yuanhaozhe2022-eng/OpenTank_Public/README.md

# OpenTank_Public
OpenTank board and code
