yuanhaozhe2022-eng/OpenTank_Public/gyro_board/gyro_board.kicad_pcb

## KiCad design gyro_board/gyro_board.kicad_pcb (2026-11-02)

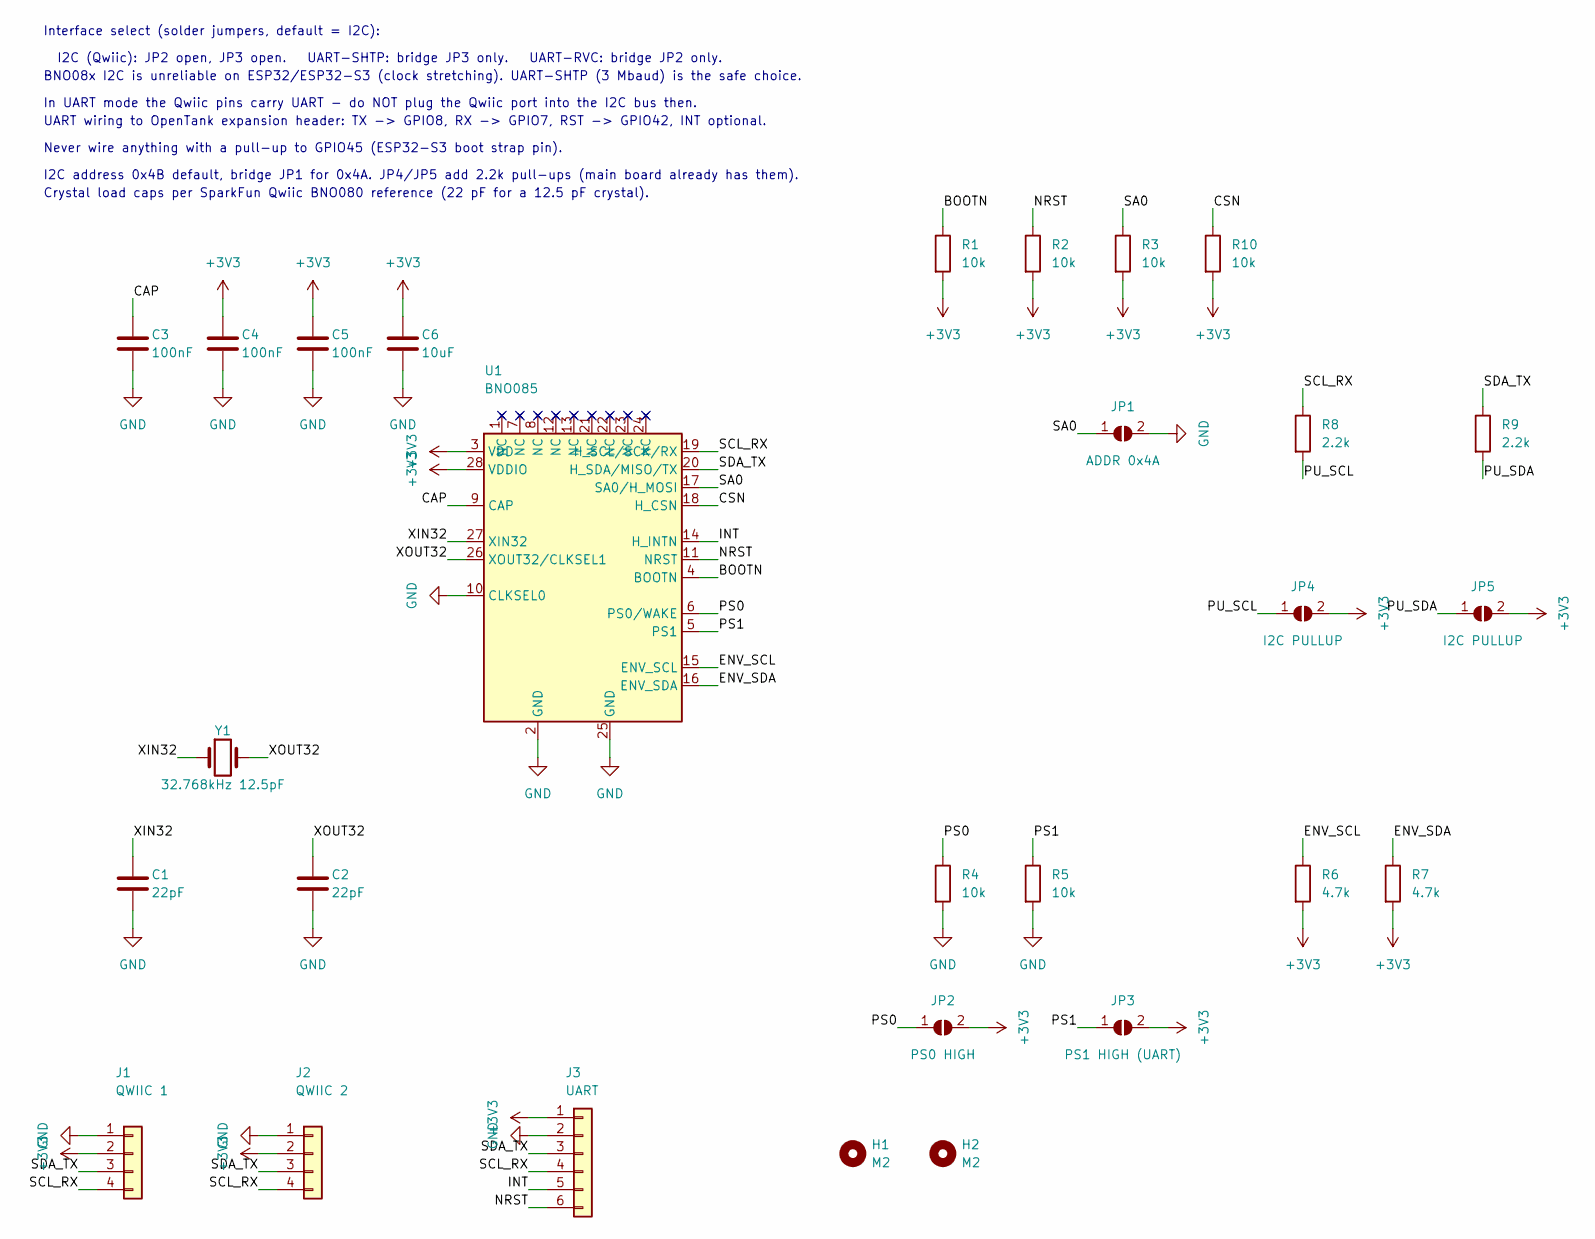
[picture p1: schematic gyro_board.kicad_sch, OpenTank Gyro - BNO085 9-axis IMU]

Parts:
C1, C2: 22pF; C_0603_1608Metric
C3, C4, C5: 100nF; C_0603_1608Metric
C6: 10uF; C_0805_2012Metric
H1, H2: M2; MountingHole_2.2mm_M2
J1: QWIIC 1; JST_SH_SM04B-SRSS-TB_1x04-1MP_P1.00mm_Horizontal; MPN JST SM04B-SRSS-TB
J2: QWIIC 2; JST_SH_SM04B-SRSS-TB_1x04-1MP_P1.00mm_Horizontal; MPN JST SM04B-SRSS-TB
J3: UART; PinHeader_1x06_P2.54mm_Vertical
JP1: ADDR 0x4A; SolderJumper-2_P1.3mm_Open_RoundedPad1.0x1.5mm
JP2: PS0 HIGH; SolderJumper-2_P1.3mm_Open_RoundedPad1.0x1.5mm
JP3: PS1 HIGH (UART); SolderJumper-2_P1.3mm_Open_RoundedPad1.0x1.5mm
JP4, JP5: I2C PULLUP; SolderJumper-2_P1.3mm_Open_RoundedPad1.0x1.5mm
R1, R2, R3, R4, R5, R10: 10k; R_0603_1608Metric
R6, R7: 4.7k; R_0603_1608Metric
R8, R9: 2.2k; R_0603_1608Metric
U1: BNO085; LGA-28_5.2x3.8mm_P0.5mm; MPN BNO085
Y1: 32.768kHz 12.5pF; Crystal_SMD_3215-2Pin_3.2x1.5mm; MPN ABS07-32.768KHZ-T

Connections:
+3V3: C4.1, C5.1, C6.1, J1.2, J2.2, J3.1, JP2.2 (B), JP3.2 (B), JP4.2 (B), JP5.2 (B), R1.2, R2.2, R3.2, R6.2, R7.2, R10.2, U1.3 (VDD), U1.28 (VDDIO)
/BOOTN: R1.1, U1.4 (BOOTN)
/CAP: C3.1, U1.9 (CAP)
/CSN: R10.1, U1.18 (H_CSN)
/ENV_SCL: R6.1, U1.15 (ENV_SCL)
/ENV_SDA: R7.1, U1.16 (ENV_SDA)
/INT: J3.5, U1.14 (H_INTN)
/NRST: J3.6, R2.1, U1.11 (NRST)
/PS0: JP2.1 (A), R4.1, U1.6 (PS0/WAKE)
/PS1: JP3.1 (A), R5.1, U1.5 (PS1)
/PU_SCL: JP4.1 (A), R8.2
/PU_SDA: JP5.1 (A), R9.2
/SA0: JP1.1 (A), R3.1, U1.17 (SA0/H_MOSI)
/SCL_RX: J1.4, J2.4, J3.4, R8.1, U1.19 (H_SCL/SCK/RX)
/SDA_TX: J1.3, J2.3, J3.3, R9.1, U1.20 (H_SDA/MISO/TX)
/XIN32: C1.1, U1.27 (XIN32), Y1.1
/XOUT32: C2.1, U1.26 (XOUT32/CLKSEL1), Y1.2
GND: C1.2, C2.2, C3.2, C4.2, C5.2, C6.2, J1.1, J2.1, J3.2, JP1.2 (B), R4.2, R5.2, U1.2 (GND), U1.10 (CLKSEL0), U1.25 (GND)

Notes on the sheet:
Interface select (solder jumpers, default = I2C):
I2C (Qwiic): JP2 open, JP3 open. UART-SHTP: bridge JP3 only. UART-RVC: bridge JP2 only.
BNO08x I2C is unreliable on ESP32/ESP32-S3 (clock stretching). UART-SHTP (3 Mbaud) is the safe choice.
In UART mode the Qwiic pins carry UART - do NOT plug the Qwiic port into the I2C bus then.
UART wiring to OpenTank expansion header: TX -> GPIO8, RX -> GPIO7, RST -> GPIO42, INT optional.
Never wire anything with a pull-up to GPIO45 (ESP32-S3 boot strap pin).
I2C address 0x4B default, bridge JP1 for 0x4A. JP4/JP5 add 2.2k pull-ups (main board already has them).
Crystal load caps per SparkFun Qwiic BNO080 reference (22 pF for a 12.5 pF crystal).

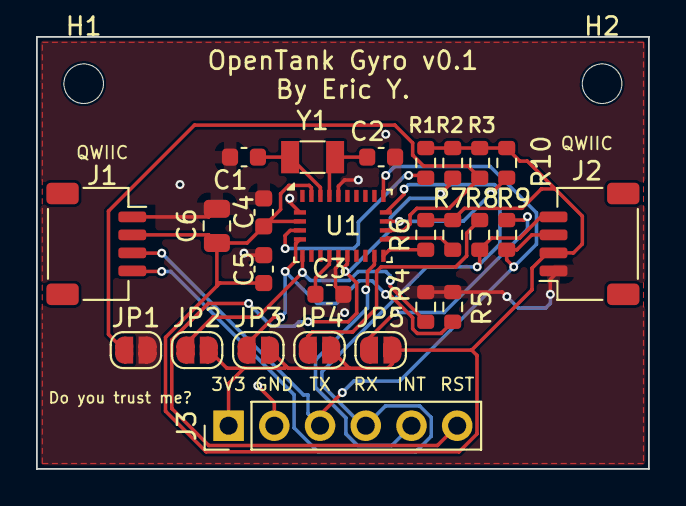
[picture p2: board gyro_board.kicad_pcb from above]

Board: 2 copper layers, 34.0 x 24.0 mm, 28 parts (0 on the bottom side), 18 nets.
