yuanhaozhe2022-eng/OpenTank_Public/tank_board.kicad_pcb

## KiCad design tank_board.kicad_pcb (2026-10-31)

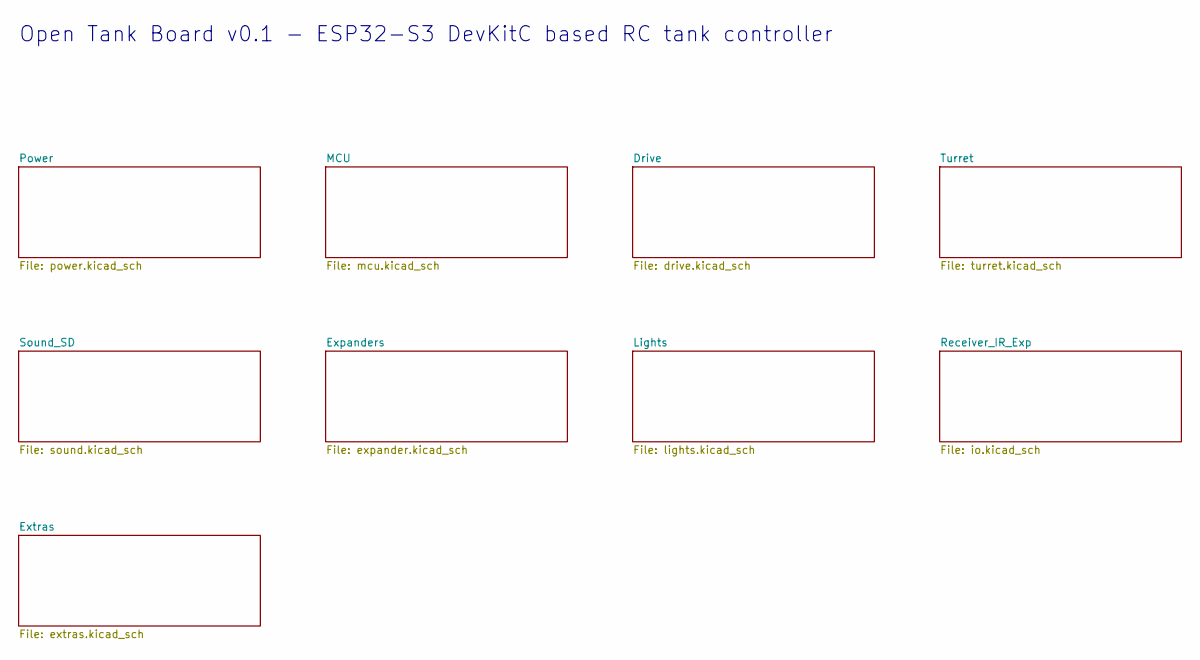
[picture p3: schematic tank_board.kicad_sch, Open Tank Board - ESP32-S3 RC tank controller]

Notes on the sheet:
Open Tank Board v0.1 - ESP32-S3 DevKitC based RC tank controller

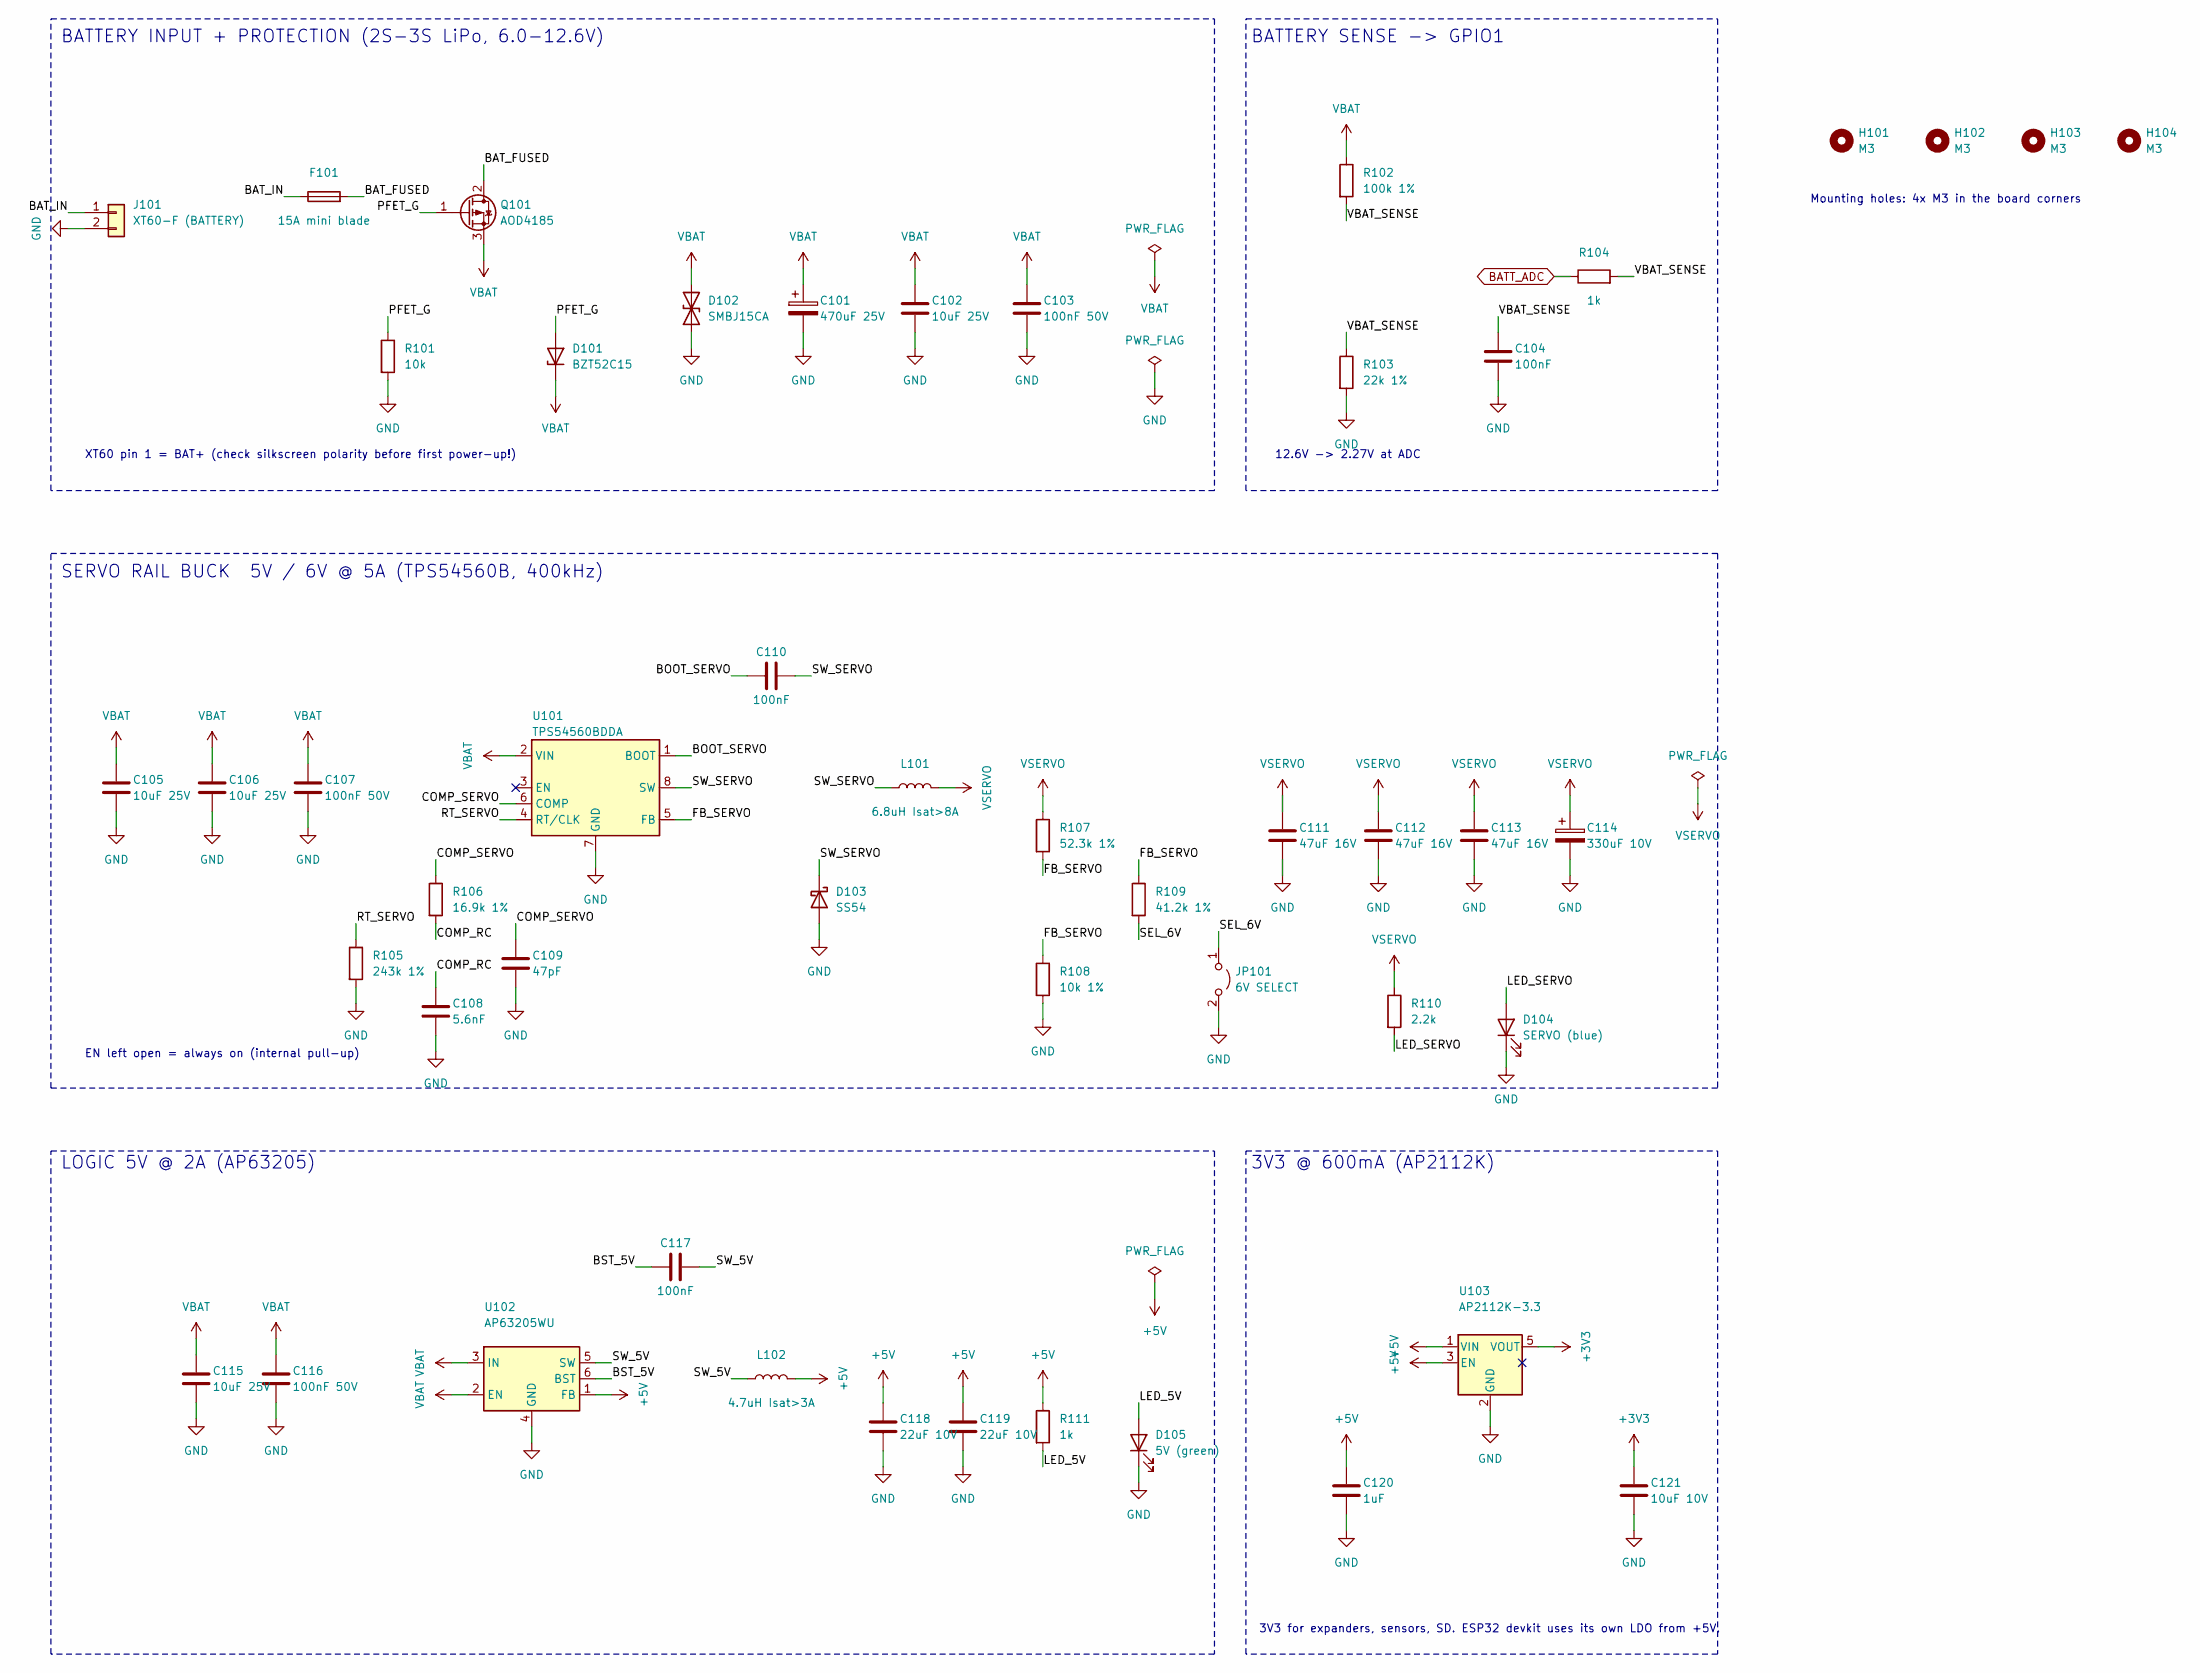
[picture p4: schematic power.kicad_sch, Tank Board - Power]

Parts:
C101: 470uF 25V; CP_Elec_10x10.5
C102, C105, C106, C115: 10uF 25V; C_1206_3216Metric
C103, C107, C116: 100nF 50V; C_0603_1608Metric
C104, C110, C117: 100nF; C_0603_1608Metric
C108: 5.6nF; C_0603_1608Metric
C109: 47pF; C_0603_1608Metric
C111, C112, C113: 47uF 16V; C_1210_3225Metric
C114: 330uF 10V; CP_Elec_6.3x7.7
C118, C119: 22uF 10V; C_1206_3216Metric
C120: 1uF; C_0603_1608Metric
C121: 10uF 10V; C_0805_2012Metric
D101: BZT52C15; D_SOD-123; MPN BZT52C15
D102: SMBJ15CA; D_SMB; MPN SMBJ15CA
D103: SS54; D_SMC; MPN SS54 (40V 5A)
D104: SERVO (blue); LED_0603_1608Metric
D105: 5V (green); LED_0603_1608Metric
F101: 15A mini blade; Fuseholder_Blade_Mini_Keystone_3568; MPN Keystone 3568 + 15A ATM fuse
H101, H102, H103, H104: M3; MountingHole_3.2mm_M3
J101: XT60-F (BATTERY); AMASS_XT60-F_1x02_P7.20mm_Vertical; MPN AMASS XT60-F
JP101: 6V SELECT; PinHeader_1x02_P2.54mm_Vertical
L101: 6.8uH Isat>8A; L_Bourns_SRP1038C_10.0x10.0mm; MPN Bourns SRP1038C-6R8M
L102: 4.7uH Isat>3A; L_Bourns_SRP5030T; MPN Bourns SRP5030T-4R7M
Q101: AOD4185; TO-252-2; MPN AOD4185
R101: 10k; R_0603_1608Metric
R102: 100k 1%; R_0603_1608Metric
R103: 22k 1%; R_0603_1608Metric
R104, R111: 1k; R_0603_1608Metric
R105: 243k 1%; R_0603_1608Metric
R106: 16.9k 1%; R_0603_1608Metric
R107: 52.3k 1%; R_0603_1608Metric
R108: 10k 1%; R_0603_1608Metric
R109: 41.2k 1%; R_0603_1608Metric
R110: 2.2k; R_0603_1608Metric
U101: TPS54560BDDA; Texas_R-PDSO-G8_EP2.95x4.9mm_Mask2.4x3.1mm_ThermalVias; MPN TPS54560BDDAR
U102: AP63205WU; TSOT-23-6; MPN AP63205WU-7
U103: AP2112K-3.3; SOT-23-5; MPN AP2112K-3.3TRG1

Connections:
+3V3: C121.1, U103.5 (VOUT); also elsewhere on the board
+5V: C118.1, C119.1, C120.1, L102.2, R111.1, U102.1 (FB), U103.1 (VIN), U103.3 (EN); also elsewhere on the board
/Power/BAT_FUSED: F101.2, Q101.2 (D)
/Power/BAT_IN: F101.1, J101.1
/Power/BOOT_SERVO: C110.1, U101.1 (BOOT)
/Power/BST_5V: C117.1, U102.6 (BST)
/Power/COMP_RC: C108.1, R106.2
/Power/COMP_SERVO: C109.1, R106.1, U101.6 (COMP)
/Power/FB_SERVO: R107.2, R108.1, R109.1, U101.5 (FB)
/Power/LED_5V: D105.2 (A), R111.2
/Power/LED_SERVO: D104.2 (A), R110.2
/Power/PFET_G: D101.2 (A), Q101.1 (G), R101.1
/Power/RT_SERVO: R105.1, U101.4 (RT/CLK)
/Power/SEL_6V: JP101.1 (A), R109.2
/Power/SW_5V: C117.2, L102.1, U102.5 (SW)
/Power/SW_SERVO: C110.2, D103.1 (K), L101.1, U101.8 (SW)
/Power/VBAT_SENSE: C104.1, R102.2, R103.1, R104.2
BATT_ADC: R104.1; also elsewhere on the board
GND: C101.2, C102.2, C103.2, C104.2, C105.2, C106.2, C107.2, C108.2, C109.2, C111.2, C112.2, C113.2, C114.2, C115.2, C116.2, C118.2, C119.2, C120.2, C121.2, D102.1 (A1), D103.2 (A), D104.1 (K), D105.1 (K), J101.2, JP101.2 (B), R101.2, R103.2, R105.2, R108.2, U101.7 (GND), U101.9 (GND), U102.4 (GND), U103.2 (GND); also elsewhere on the board
VBAT: C101.1, C102.1, C103.1, C105.1, C106.1, C107.1, C115.1, C116.1, D101.1 (K), D102.2 (A2), Q101.3 (S), R102.1, U101.2 (VIN), U102.2 (EN), U102.3 (IN); also elsewhere on the board
VSERVO: C111.1, C112.1, C113.1, C114.1, L101.2, R107.1, R110.1; also elsewhere on the board

Notes on the sheet:
BATTERY INPUT + PROTECTION (2S-3S LiPo, 6.0-12.6V)
XT60 pin 1 = BAT+ (check silkscreen polarity before first power-up!)
BATTERY SENSE -> GPIO1
12.6V -> 2.27V at ADC
SERVO RAIL BUCK 5V / 6V @ 5A (TPS54560B, 400kHz)
EN left open = always on (internal pull-up)
LOGIC 5V @ 2A (AP63205)
3V3 @ 600mA (AP2112K)
3V3 for expanders, sensors, SD. ESP32 devkit uses its own LDO from +5V.
Mounting holes: 4x M3 in the board corners

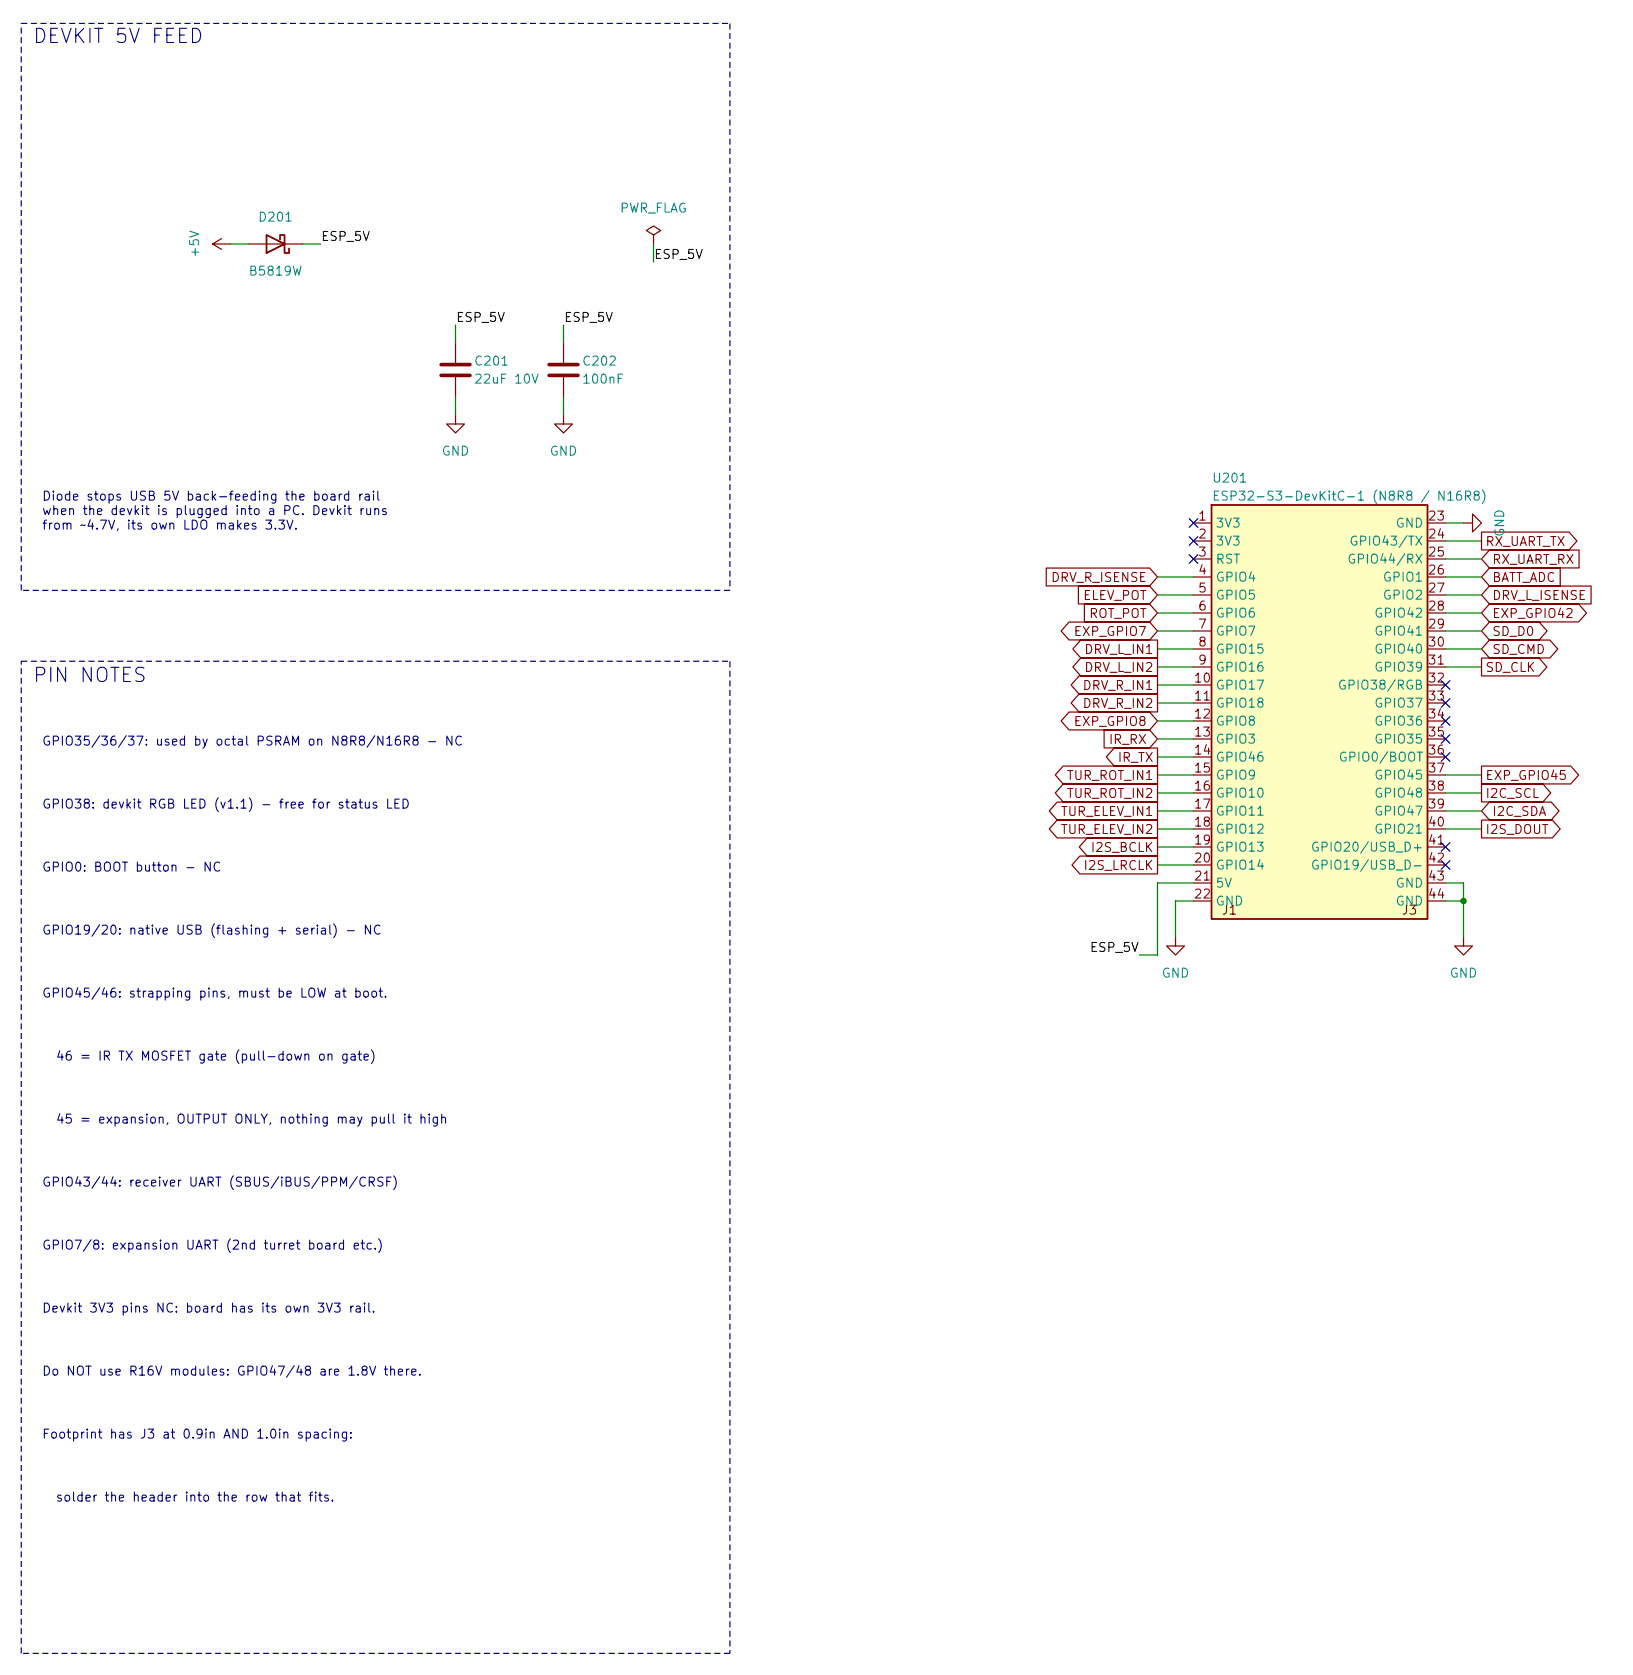
[picture p5: schematic mcu.kicad_sch, Tank Board - ESP32-S3 DevKitC-1 socket]

Parts:
C201: 22uF 10V; C_1206_3216Metric
C202: 100nF; C_0603_1608Metric
D201: B5819W; D_SOD-123; MPN B5819W (40V 1A)
U201: ESP32-S3-DevKitC-1 (N8R8 / N16R8); ESP32-S3-DevKitC-1_Socket; MPN ESP32-S3-DevKitC-1 + 2x 1x22 female hea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

Connections:
+5V: D201.2 (A); also elsewhere on the board
/MCU/ESP_5V: C201.1, C202.1, D201.1 (K), U201.21 (5V)
BATT_ADC: U201.26 (GPIO1); also elsewhere on the board
DRV_L_IN1: U201.8 (GPIO15); also elsewhere on the board
DRV_L_IN2: U201.9 (GPIO16); also elsewhere on the board
DRV_L_ISENSE: U201.27 (GPIO2); also elsewhere on the board
DRV_R_IN1: U201.10 (GPIO17); also elsewhere on the board
DRV_R_IN2: U201.11 (GPIO18); also elsewhere on the board
DRV_R_ISENSE: U201.4 (GPIO4); also elsewhere on the board
ELEV_POT: U201.5 (GPIO5); also elsewhere on the board
EXP_GPIO7: U201.7 (GPIO7); also elsewhere on the board
EXP_GPIO8: U201.12 (GPIO8); also elsewhere on the board
EXP_GPIO42: U201.28 (GPIO42); also elsewhere on the board
EXP_GPIO45: U201.37 (GPIO45); also elsewhere on the board
GND: C201.2, C202.2, U201.22 (GND), U201.23 (GND), U201.43 (GND), U201.44 (GND); also elsewhere on the board
I2C_SCL: U201.38 (GPIO48); also elsewhere on the board
I2C_SDA: U201.39 (GPIO47); also elsewhere on the board
I2S_BCLK: U201.19 (GPIO13); also elsewhere on the board
I2S_DOUT: U201.40 (GPIO21); also elsewhere on the board
I2S_LRCLK: U201.20 (GPIO14); also elsewhere on the board
IR_RX: U201.13 (GPIO3); also elsewhere on the board
IR_TX: U201.14 (GPIO46); also elsewhere on the board
ROT_POT: U201.6 (GPIO6); also elsewhere on the board
RX_UART_RX: U201.25 (GPIO44/RX); also elsewhere on the board
RX_UART_TX: U201.24 (GPIO43/TX); also elsewhere on the board
SD_CLK: U201.31 (GPIO39); also elsewhere on the board
SD_CMD: U201.30 (GPIO40); also elsewhere on the board
SD_D0: U201.29 (GPIO41); also elsewhere on the board
TUR_ELEV_IN1: U201.17 (GPIO11); also elsewhere on the board
TUR_ELEV_IN2: U201.18 (GPIO12); also elsewhere on the board
TUR_ROT_IN1: U201.15 (GPIO9); also elsewhere on the board
TUR_ROT_IN2: U201.16 (GPIO10); also elsewhere on the board

Notes on the sheet:
DEVKIT 5V FEED
Diode stops USB 5V back-feeding the board rail when the devkit is plugged into a PC. Devkit runs from ~4.7V, its own LDO makes 3.3V.
PIN NOTES
GPIO35/36/37: used by octal PSRAM on N8R8/N16R8 - NC
GPIO38: devkit RGB LED (v1.1) - free for status LED
GPIO0: BOOT button - NC
GPIO19/20: native USB (flashing + serial) - NC
GPIO45/46: strapping pins, must be LOW at boot.
46 = IR TX MOSFET gate (pull-down on gate)
45 = expansion, OUTPUT ONLY, nothing may pull it high
GPIO43/44: receiver UART (SBUS/iBUS/PPM/CRSF)
GPIO7/8: expansion UART (2nd turret board etc.)
Devkit 3V3 pins NC: board has its own 3V3 rail.
Do NOT use R16V modules: GPIO47/48 are 1.8V there.
Footprint has J3 at 0.9in AND 1.0in spacing:
solder the header into the row that fits.

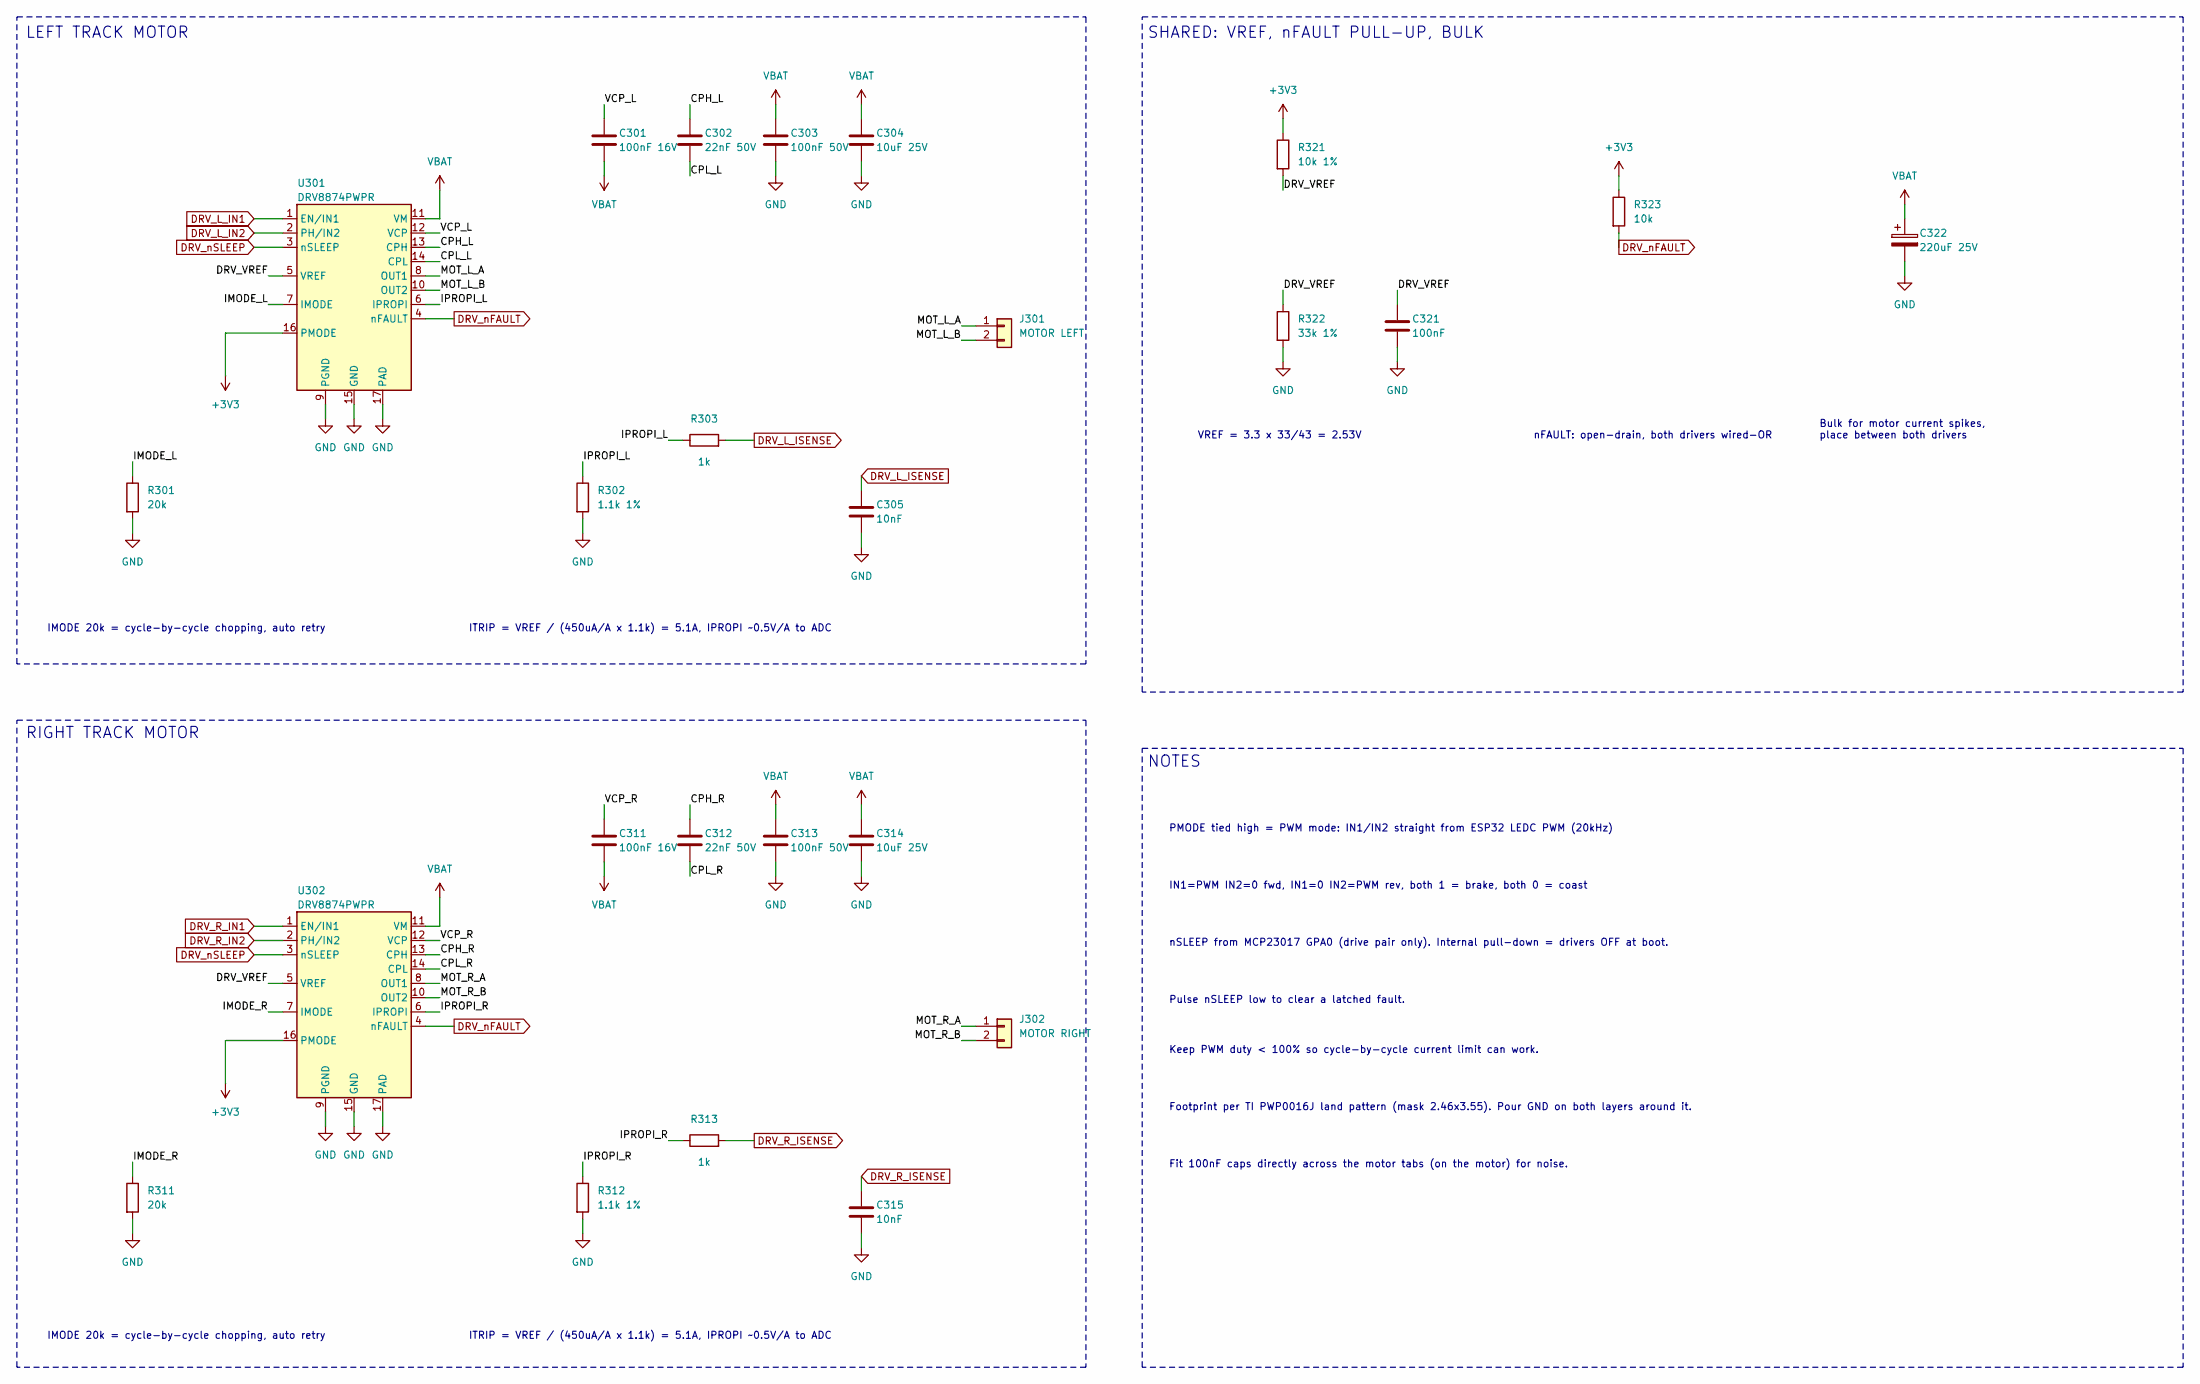
[picture p6: schematic drive.kicad_sch, Tank Board - Drive motors (2x DRV8874)]

Parts:
C301, C311: 100nF 16V; C_0603_1608Metric
C302, C312: 22nF 50V; C_0603_1608Metric
C303, C313: 100nF 50V; C_0603_1608Metric
C304, C314: 10uF 25V; C_1206_3216Metric
C305, C315: 10nF; C_0603_1608Metric
C321: 100nF; C_0603_1608Metric
C322: 220uF 25V; CP_Elec_10x10.5
J301: MOTOR LEFT; TerminalBlock_Phoenix_MKDS-1,5-2-5.08_1x02_P5.08mm_Horizont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; MPN 5.08mm 2-pos screw terminal
J302: MOTOR RIGHT; TerminalBlock_Phoenix_MKDS-1,5-2-5.08_1x02_P5.08mm_Horizont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; MPN 5.08mm 2-pos screw terminal
R301, R311: 20k; R_0603_1608Metric
R302, R312: 1.1k 1%; R_0603_1608Metric
R303, R313: 1k; R_0603_1608Metric
R321: 10k 1%; R_0603_1608Metric
R322: 33k 1%; R_0603_1608Metric
R323: 10k; R_0603_1608Metric
U301, U302: DRV8874PWPR; DRV887x_HTSSOP-16_PWP0016J_ThermalVias; MPN DRV8874PWPR

Connections:
+3V3: R321.1, R323.1, U301.16 (PMODE), U302.16 (PMODE); also elsewhere on the board
/Drive/CPH_L: C302.1, U301.13 (CPH)
/Drive/CPH_R: C312.1, U302.13 (CPH)
/Drive/CPL_L: C302.2, U301.14 (CPL)
/Drive/CPL_R: C312.2, U302.14 (CPL)
/Drive/DRV_VREF: C321.1, R321.2, R322.1, U301.5 (VREF), U302.5 (VREF)
/Drive/IMODE_L: R301.1, U301.7 (IMODE)
/Drive/IMODE_R: R311.1, U302.7 (IMODE)
/Drive/IPROPI_L: R302.1, R303.1, U301.6 (IPROPI)
/Drive/IPROPI_R: R312.1, R313.1, U302.6 (IPROPI)
/Drive/MOT_L_A: J301.1, U301.8 (OUT1)
/Drive/MOT_L_B: J301.2, U301.10 (OUT2)
/Drive/MOT_R_A: J302.1, U302.8 (OUT1)
/Drive/MOT_R_B: J302.2, U302.10 (OUT2)
/Drive/VCP_L: C301.1, U301.12 (VCP)
/Drive/VCP_R: C311.1, U302.12 (VCP)
DRV_L_IN1: U301.1 (EN/IN1); also elsewhere on the board
DRV_L_IN2: U301.2 (PH/IN2); also elsewhere on the board
DRV_L_ISENSE: C305.1, R303.2; also elsewhere on the board
DRV_R_IN1: U302.1 (EN/IN1); also elsewhere on the board
DRV_R_IN2: U302.2 (PH/IN2); also elsewhere on the board
DRV_R_ISENSE: C315.1, R313.2; also elsewhere on the board
DRV_nFAULT: R323.2, U301.4 (nFAULT), U302.4 (nFAULT); also elsewhere on the board
DRV_nSLEEP: U301.3 (nSLEEP), U302.3 (nSLEEP); also elsewhere on the board
GND: C303.2, C304.2, C305.2, C313.2, C314.2, C315.2, C321.2, C322.2, R301.2, R302.2, R311.2, R312.2, R322.2, U301.9 (PGND), U301.15 (GND), U301.17 (PAD), U302.9 (PGND), U302.15 (GND), U302.17 (PAD); also elsewhere on the board
VBAT: C301.2, C303.1, C304.1, C311.2, C313.1, C314.1, C322.1, U301.11 (VM), U302.11 (VM); also elsewhere on the board

Notes on the sheet:
LEFT TRACK MOTOR
IMODE 20k = cycle-by-cycle chopping, auto retry
ITRIP = VREF / (450uA/A x 1.1k) = 5.1A, IPROPI ~0.5V/A to ADC
RIGHT TRACK MOTOR
SHARED: VREF, nFAULT PULL-UP, BULK
VREF = 3.3 x 33/43 = 2.53V
nFAULT: open-drain, both drivers wired-OR
Bulk for motor current spikes, place between both drivers
NOTES
PMODE tied high = PWM mode: IN1/IN2 straight from ESP32 LEDC PWM (20kHz)
IN1=PWM IN2=0 fwd, IN1=0 IN2=PWM rev, both 1 = brake, both 0 = coast
nSLEEP from MCP23017 GPA0 (drive pair only). Internal pull-down = drivers OFF at boot.
Pulse nSLEEP low to clear a latched fault.
Keep PWM duty < 100% so cycle-by-cycle current limit can work.
Footprint per TI PWP0016J land pattern (mask 2.46x3.55). Pour GND on both layers around it.
Fit 100nF caps directly across the motor tabs (on the motor) for noise.
