yuanhaozhe2022-eng/OpenTank_Public/tank_board.kicad_pcb

## KiCad design tank_board.kicad_pcb (continued)

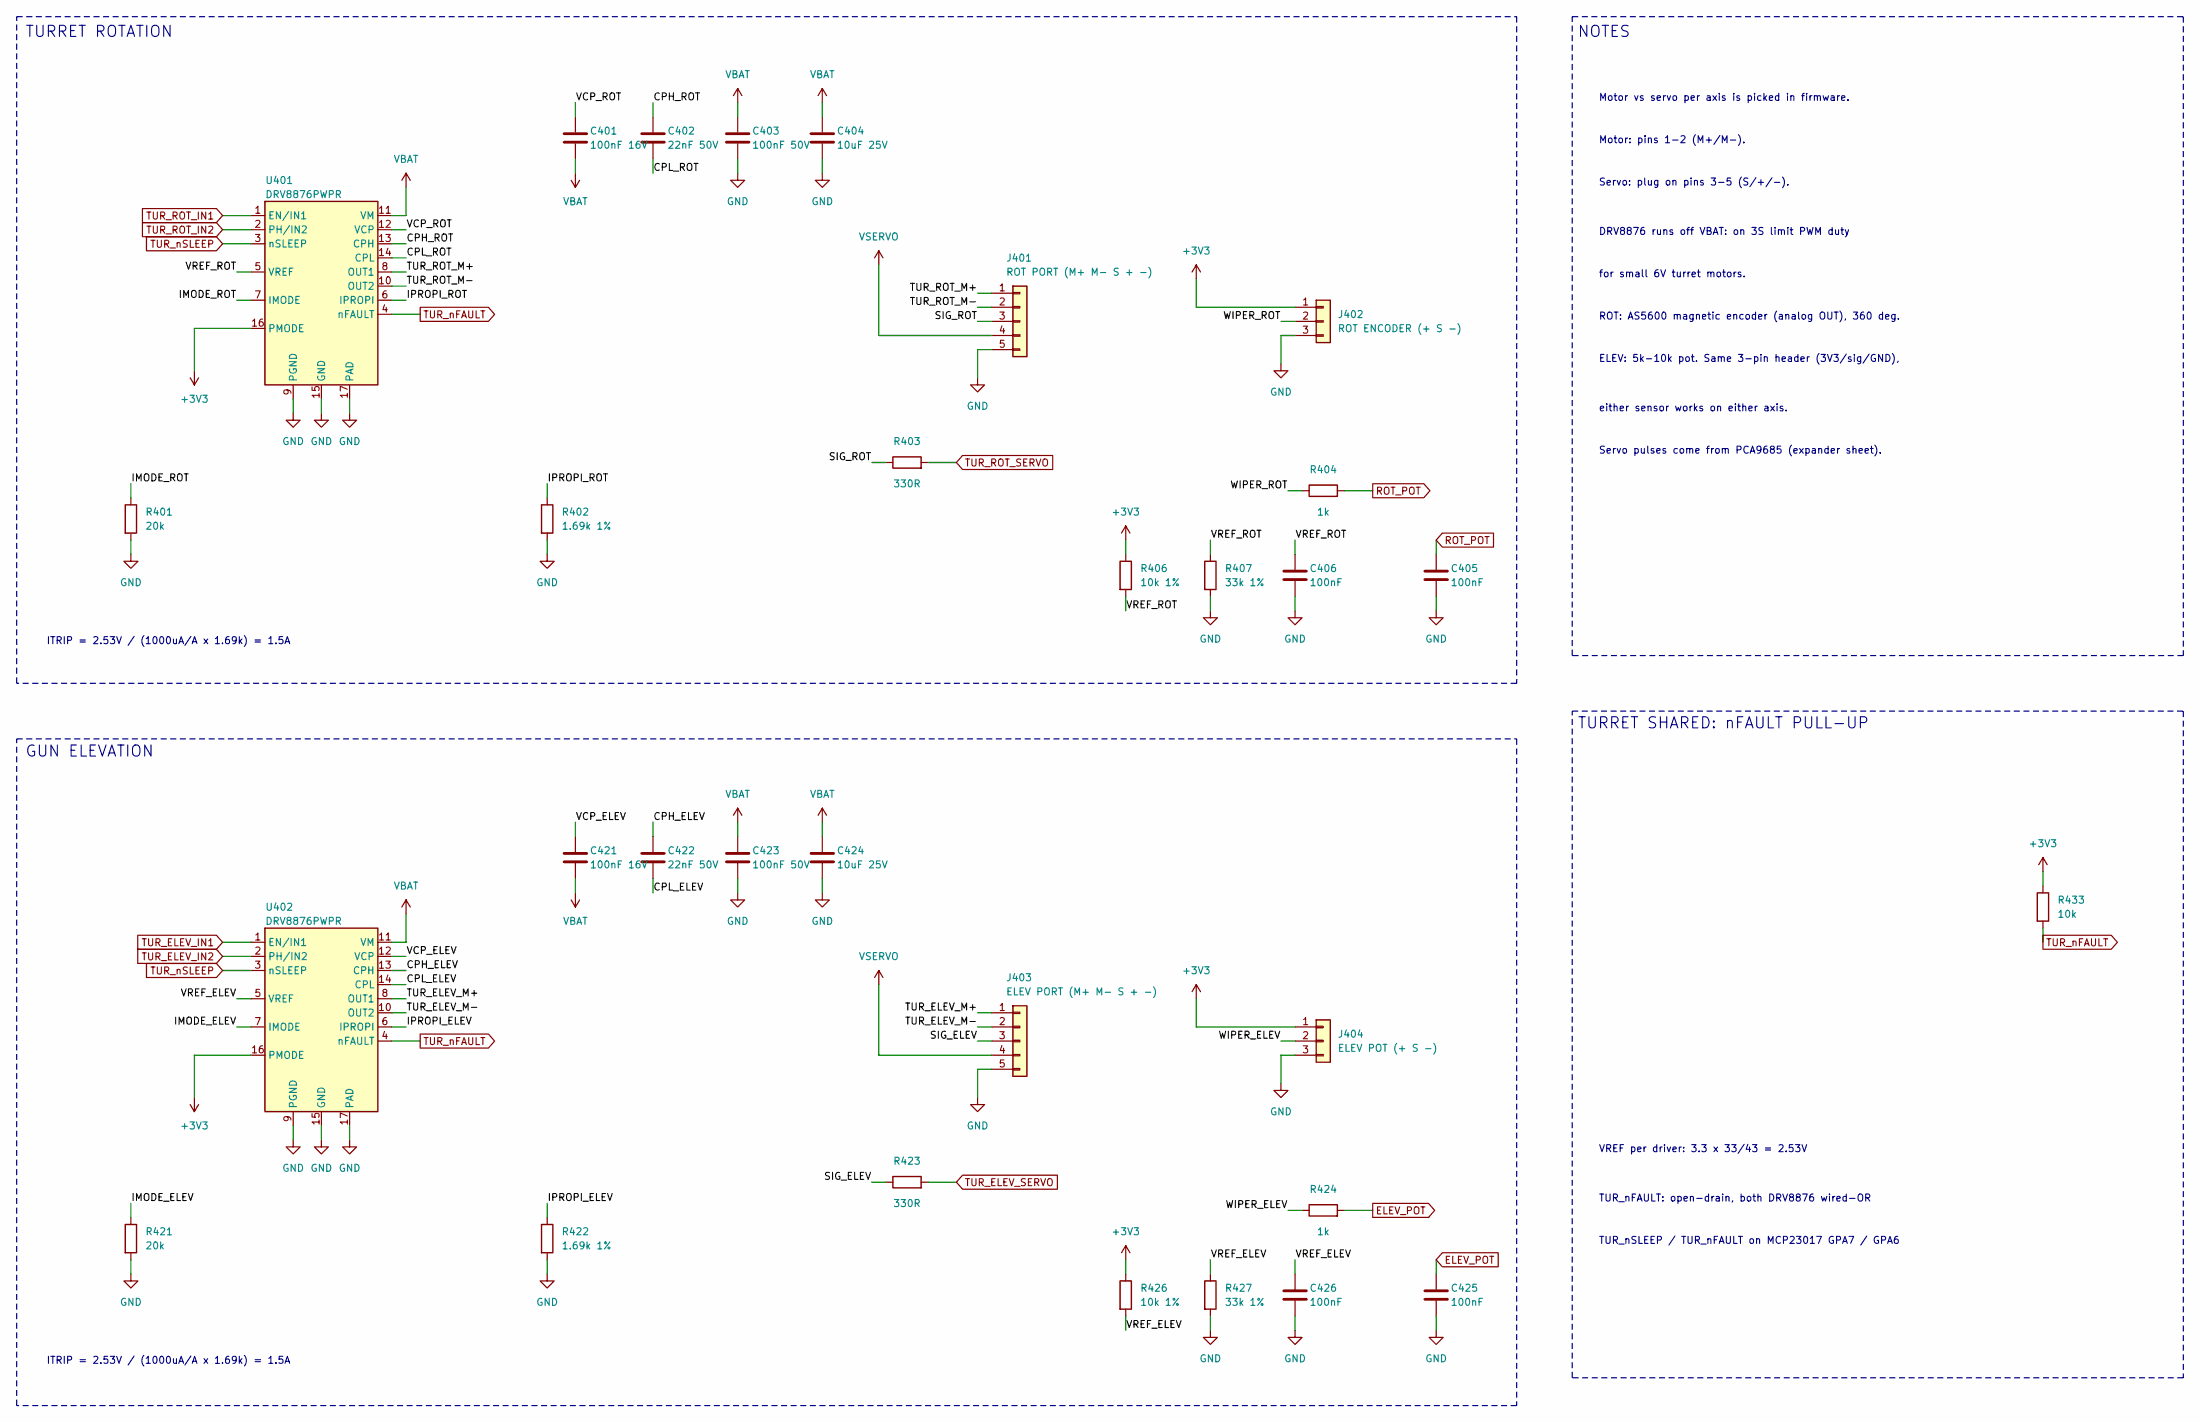
[picture p7: schematic turret.kicad_sch, Tank Board - Turret (2x DRV8876)]

Parts:
C401, C421: 100nF 16V; C_0603_1608Metric
C402, C422: 22nF 50V; C_0603_1608Metric
C403, C423: 100nF 50V; C_0603_1608Metric
C404, C424: 10uF 25V; C_1206_3216Metric
C405, C406, C425, C426: 100nF; C_0603_1608Metric
J401: ROT PORT (M+ M- S + -); PinHeader_1x05_P2.54mm_Vertical
J402: ROT ENCODER (+ S -); PinHeader_1x03_P2.54mm_Vertical
J403: ELEV PORT (M+ M- S + -); PinHeader_1x05_P2.54mm_Vertical
J404: ELEV POT (+ S -); PinHeader_1x03_P2.54mm_Vertical
R401, R421: 20k; R_0603_1608Metric
R402, R422: 1.69k 1%; R_0603_1608Metric
R403, R423: 330R; R_0603_1608Metric
R404, R424: 1k; R_0603_1608Metric
R406, R426: 10k 1%; R_0603_1608Metric
R407, R427: 33k 1%; R_0603_1608Metric
R433: 10k; R_0603_1608Metric
U401, U402: DRV8876PWPR; DRV887x_HTSSOP-16_PWP0016J_ThermalVias; MPN DRV8876PWPR

Connections:
+3V3: J402.1, J404.1, R406.1, R426.1, R433.1, U401.16 (PMODE), U402.16 (PMODE); also elsewhere on the board
/Turret/CPH_ELEV: C422.1, U402.13 (CPH)
/Turret/CPH_ROT: C402.1, U401.13 (CPH)
/Turret/CPL_ELEV: C422.2, U402.14 (CPL)
/Turret/CPL_ROT: C402.2, U401.14 (CPL)
/Turret/IMODE_ELEV: R421.1, U402.7 (IMODE)
/Turret/IMODE_ROT: R401.1, U401.7 (IMODE)
/Turret/IPROPI_ELEV: R422.1, U402.6 (IPROPI)
/Turret/IPROPI_ROT: R402.1, U401.6 (IPROPI)
/Turret/SIG_ELEV: J403.3, R423.1
/Turret/SIG_ROT: J401.3, R403.1
/Turret/TUR_ELEV_M+: J403.1, U402.8 (OUT1)
/Turret/TUR_ELEV_M-: J403.2, U402.10 (OUT2)
/Turret/TUR_ROT_M+: J401.1, U401.8 (OUT1)
/Turret/TUR_ROT_M-: J401.2, U401.10 (OUT2)
/Turret/VCP_ELEV: C421.1, U402.12 (VCP)
/Turret/VCP_ROT: C401.1, U401.12 (VCP)
/Turret/VREF_ELEV: C426.1, R426.2, R427.1, U402.5 (VREF)
/Turret/VREF_ROT: C406.1, R406.2, R407.1, U401.5 (VREF)
/Turret/WIPER_ELEV: J404.2, R424.1
/Turret/WIPER_ROT: J402.2, R404.1
ELEV_POT: C425.1, R424.2; also elsewhere on the board
GND: C403.2, C404.2, C405.2, C406.2, C423.2, C424.2, C425.2, C426.2, J401.5, J402.3, J403.5, J404.3, R401.2, R402.2, R407.2, R421.2, R422.2, R427.2, U401.9 (PGND), U401.15 (GND), U401.17 (PAD), U402.9 (PGND), U402.15 (GND), U402.17 (PAD); also elsewhere on the board
ROT_POT: C405.1, R404.2; also elsewhere on the board
TUR_ELEV_IN1: U402.1 (EN/IN1); also elsewhere on the board
TUR_ELEV_IN2: U402.2 (PH/IN2); also elsewhere on the board
TUR_ELEV_SERVO: R423.2; also elsewhere on the board
TUR_ROT_IN1: U401.1 (EN/IN1); also elsewhere on the board
TUR_ROT_IN2: U401.2 (PH/IN2); also elsewhere on the board
TUR_ROT_SERVO: R403.2; also elsewhere on the board
TUR_nFAULT: R433.2, U401.4 (nFAULT), U402.4 (nFAULT); also elsewhere on the board
TUR_nSLEEP: U401.3 (nSLEEP), U402.3 (nSLEEP); also elsewhere on the board
VBAT: C401.2, C403.1, C404.1, C421.2, C423.1, C424.1, U401.11 (VM), U402.11 (VM); also elsewhere on the board
VSERVO: J401.4, J403.4; also elsewhere on the board

Notes on the sheet:
TURRET ROTATION
ITRIP = 2.53V / (1000uA/A x 1.69k) = 1.5A
GUN ELEVATION
TURRET SHARED: nFAULT PULL-UP
VREF per driver: 3.3 x 33/43 = 2.53V
TUR_nFAULT: open-drain, both DRV8876 wired-OR
TUR_nSLEEP / TUR_nFAULT on MCP23017 GPA7 / GPA6
NOTES
Motor vs servo per axis is picked in firmware.
Motor: pins 1-2 (M+/M-).
Servo: plug on pins 3-5 (S/+/-).
DRV8876 runs off VBAT: on 3S limit PWM duty
for small 6V turret motors.
ROT: AS5600 magnetic encoder (analog OUT), 360 deg.
ELEV: 5k-10k pot. Same 3-pin header (3V3/sig/GND),
either sensor works on either axis.
Servo pulses come from PCA9685 (expander sheet).

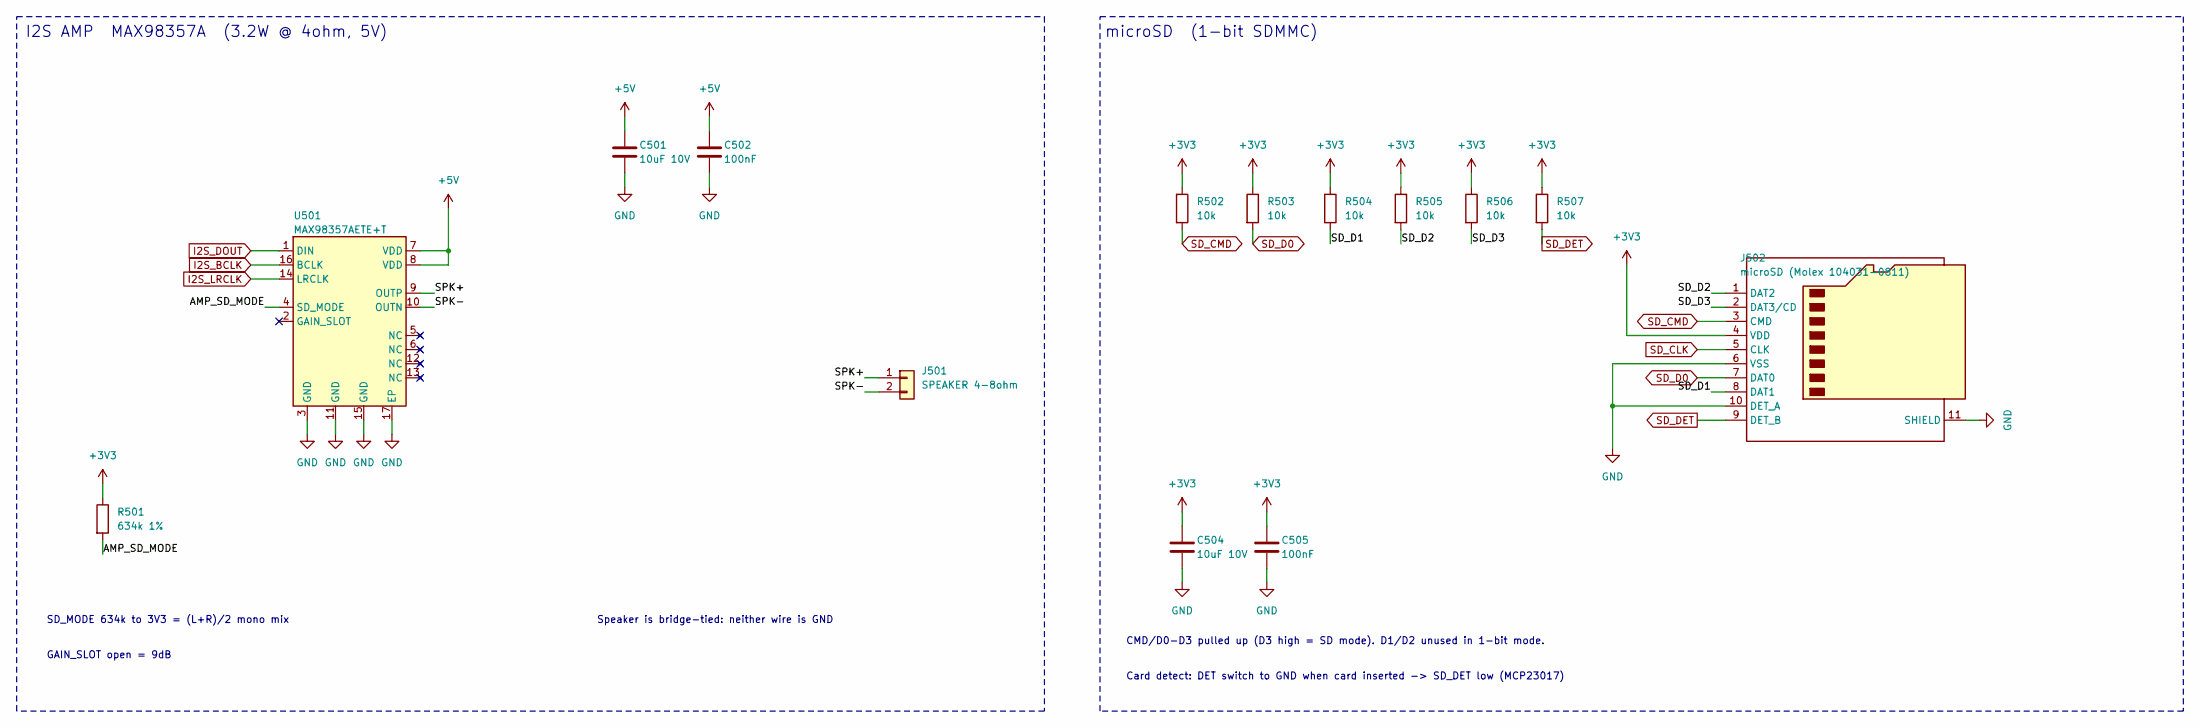
[picture p8: schematic sound.kicad_sch, Tank Board - Sound (MAX98357A) + microSD]

Parts:
C501, C504: 10uF 10V; C_0805_2012Metric
C502, C505: 100nF; C_0603_1608Metric
J501: SPEAKER 4-8ohm; JST_PH_B2B-PH-K_1x02_P2.00mm_Vertical; MPN JST B2B-PH-K-S
J502: microSD (Molex 104031-0811); microSD_HC_Molex_104031-0811; MPN Molex 104031-0811
R501: 634k 1%; R_0603_1608Metric
R502, R503, R504, R505, R506, R507: 10k; R_0603_1608Metric
U501: MAX98357AETE+T; TQFN-16-1EP_3x3mm_P0.5mm_EP1.23x1.23mm_ThermalVias; MPN MAX98357AETE+T

Connections:
+3V3: C504.1, C505.1, J502.4 (VDD), R501.1, R502.1, R503.1, R504.1, R505.1, R506.1, R507.1; also elsewhere on the board
+5V: C501.1, C502.1, U501.7 (VDD), U501.8 (VDD); also elsewhere on the board
/Sound_SD/AMP_SD_MODE: R501.2, U501.4 (SD_MODE)
/Sound_SD/SD_D1: J502.8 (DAT1), R504.2
/Sound_SD/SD_D2: J502.1 (DAT2), R505.2
/Sound_SD/SD_D3: J502.2 (DAT3/CD), R506.2
/Sound_SD/SPK+: J501.1, U501.9 (OUTP)
/Sound_SD/SPK-: J501.2, U501.10 (OUTN)
GND: C501.2, C502.2, C504.2, C505.2, J502.6 (VSS), J502.10 (DET_A), J502.11 (SHIELD), U501.3 (GND), U501.11 (GND), U501.15 (GND), U501.17 (EP); also elsewhere on the board
I2S_BCLK: U501.16 (BCLK); also elsewhere on the board
I2S_DOUT: U501.1 (DIN); also elsewhere on the board
I2S_LRCLK: U501.14 (LRCLK); also elsewhere on the board
SD_CLK: J502.5 (CLK); also elsewhere on the board
SD_CMD: J502.3 (CMD), R502.2; also elsewhere on the board
SD_D0: J502.7 (DAT0), R503.2; also elsewhere on the board
SD_DET: J502.9 (DET_B), R507.2; also elsewhere on the board

Notes on the sheet:
I2S AMP MAX98357A (3.2W @ 4ohm, 5V)
SD_MODE 634k to 3V3 = (L+R)/2 mono mix
GAIN_SLOT open = 9dB
Speaker is bridge-tied: neither wire is GND
microSD (1-bit SDMMC)
CMD/D0-D3 pulled up (D3 high = SD mode). D1/D2 unused in 1-bit mode.
Card detect: DET switch to GND when card inserted -> SD_DET low (MCP23017)

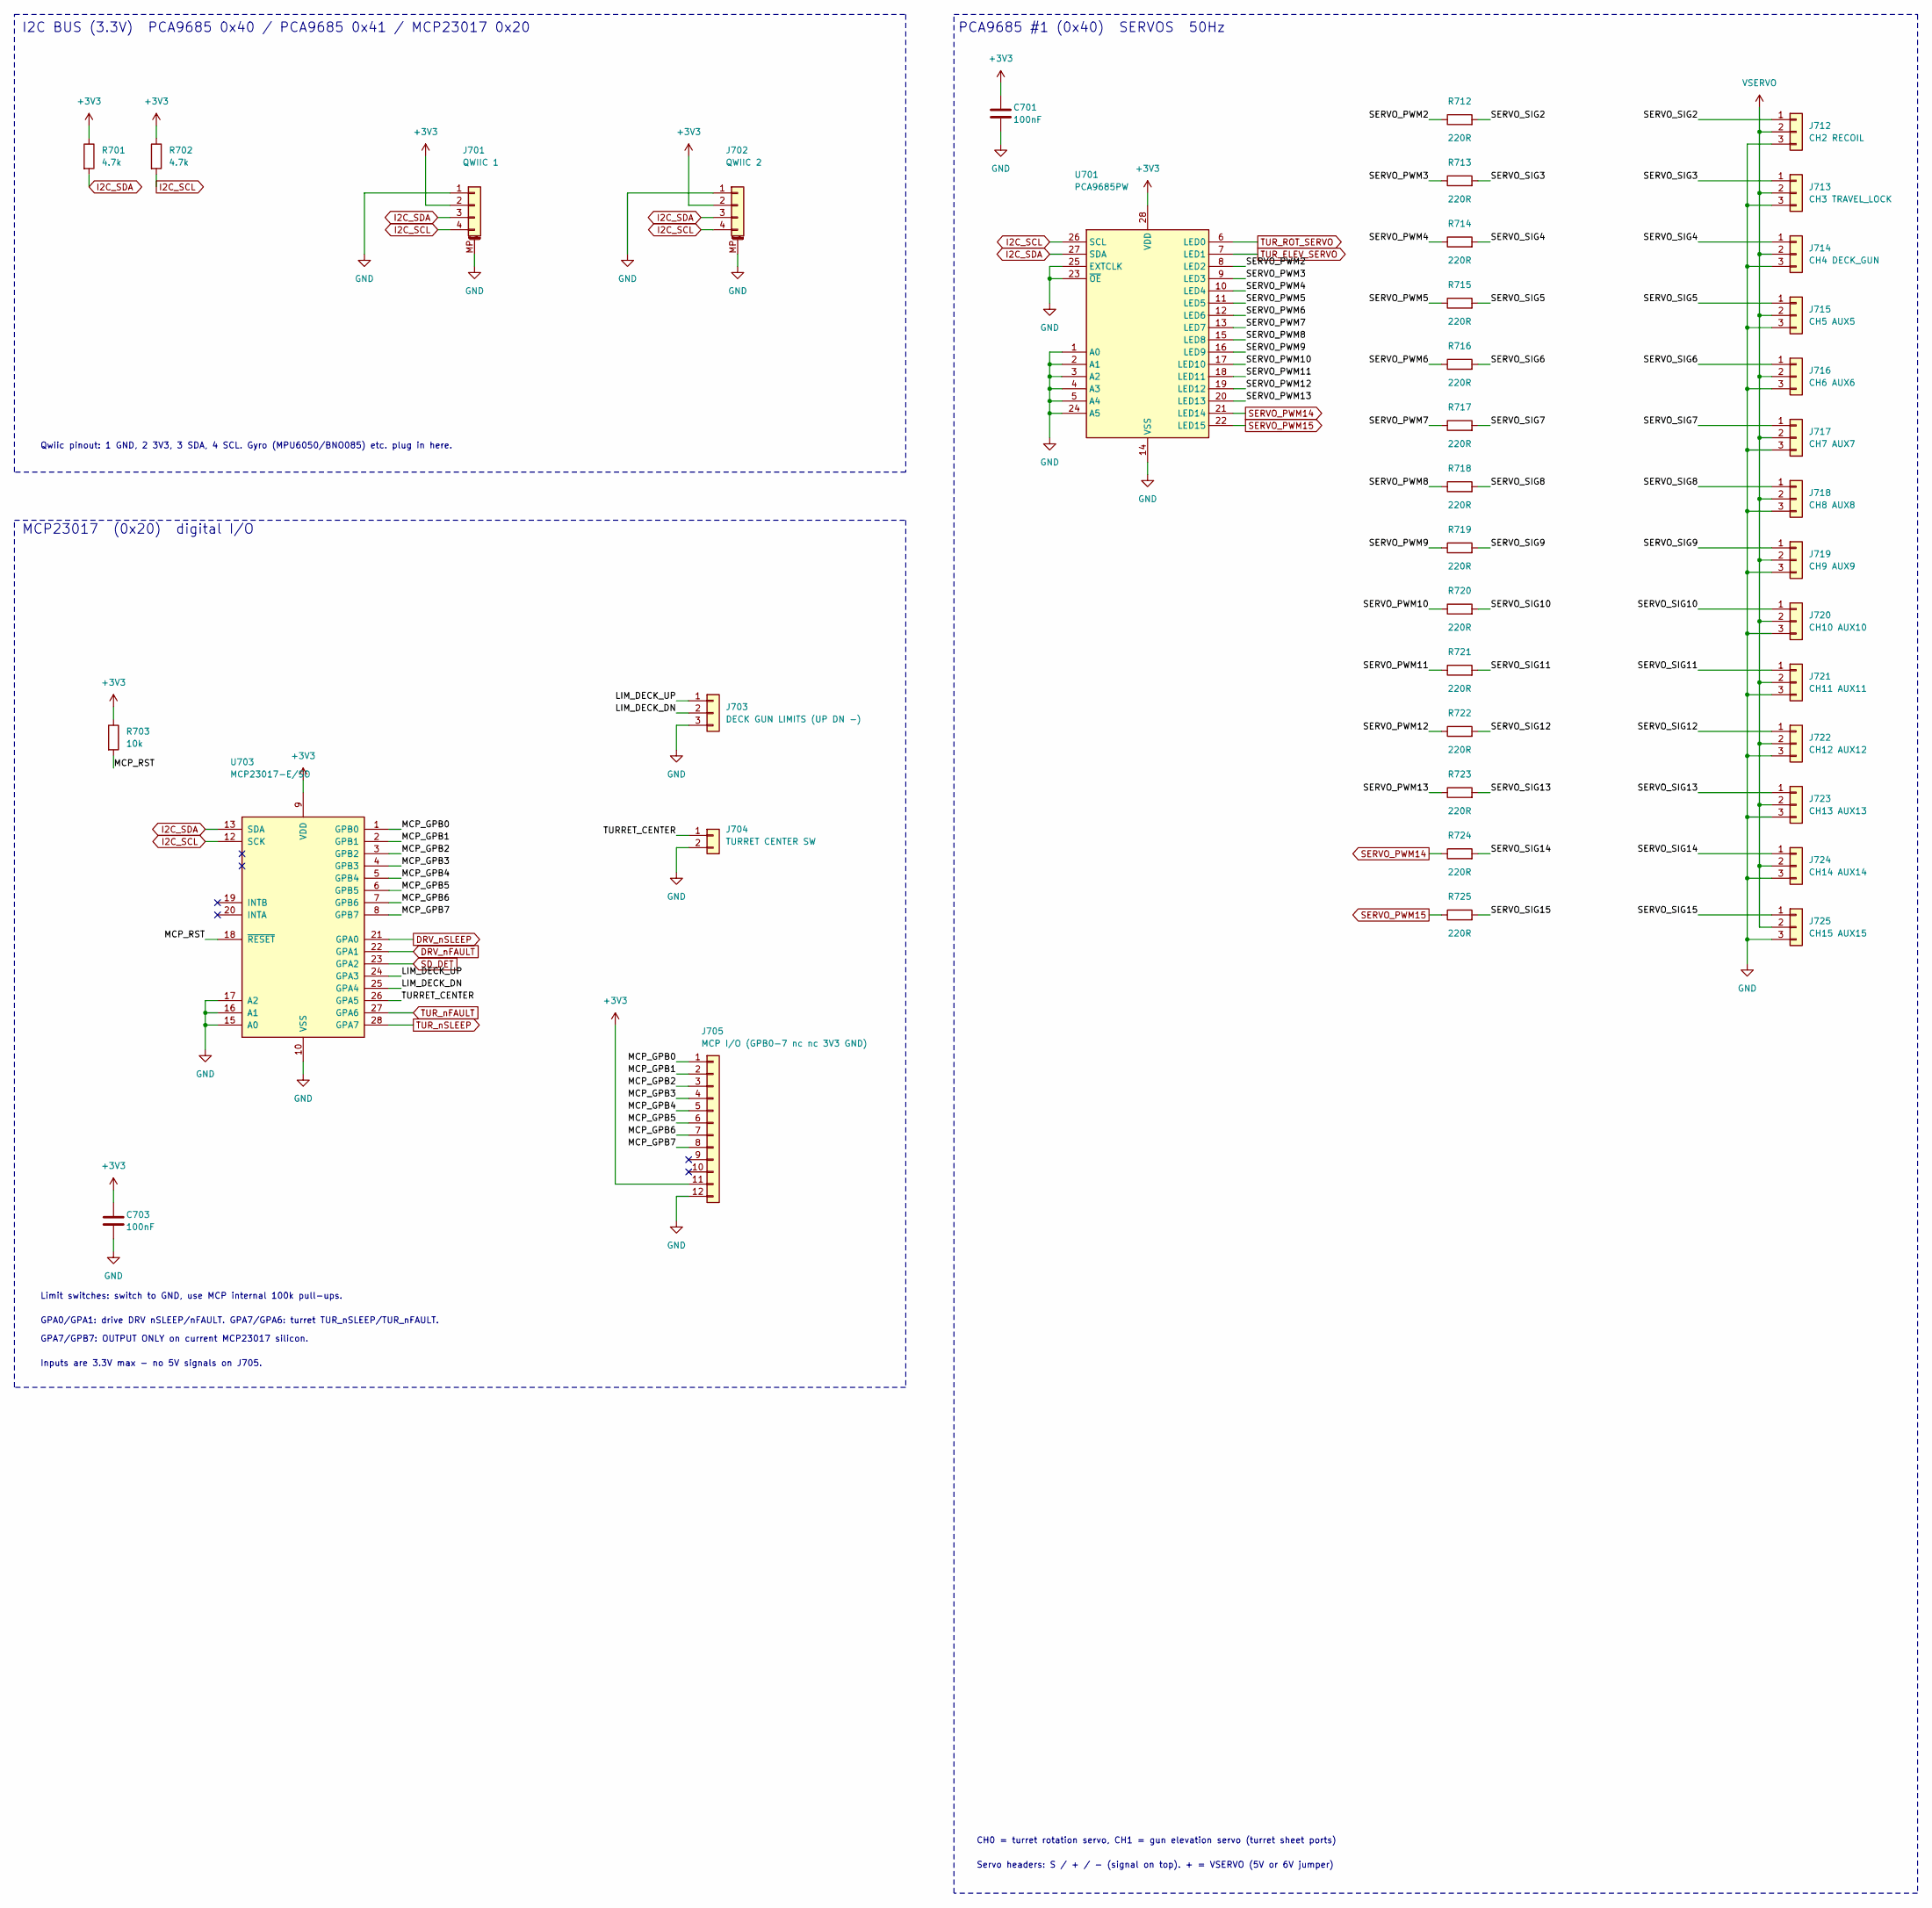
[picture p9: schematic expander.kicad_sch, Tank Board - I2C bus, MCP23017 inputs, PCA9685 servos]

Parts:
C701, C703: 100nF; C_0603_1608Metric
J701: QWIIC 1; JST_SH_SM04B-SRSS-TB_1x04-1MP_P1.00mm_Horizontal; MPN JST SM04B-SRSS-TB
J702: QWIIC 2; JST_SH_SM04B-SRSS-TB_1x04-1MP_P1.00mm_Horizontal; MPN JST SM04B-SRSS-TB
J703: DECK GUN LIMITS (UP DN -); PinHeader_1x03_P2.54mm_Vertical
J704: TURRET CENTER SW; PinHeader_1x02_P2.54mm_Vertical
J705: MCP I/O (GPB0-7 nc nc 3V3 GND); PinHeader_2x06_P2.54mm_Vertical
J712: CH2 RECOIL; PinHeader_1x03_P2.54mm_Vertical
J713: CH3 TRAVEL_LOCK; PinHeader_1x03_P2.54mm_Vertical
J714: CH4 DECK_GUN; PinHeader_1x03_P2.54mm_Vertical
J715: CH5 AUX5; PinHeader_1x03_P2.54mm_Vertical
J716: CH6 AUX6; PinHeader_1x03_P2.54mm_Vertical
J717: CH7 AUX7; PinHeader_1x03_P2.54mm_Vertical
J718: CH8 AUX8; PinHeader_1x03_P2.54mm_Vertical
J719: CH9 AUX9; PinHeader_1x03_P2.54mm_Vertical
J720: CH10 AUX10; PinHeader_1x03_P2.54mm_Vertical
J721: CH11 AUX11; PinHeader_1x03_P2.54mm_Vertical
J722: CH12 AUX12; PinHeader_1x03_P2.54mm_Vertical
J723: CH13 AUX13; PinHeader_1x03_P2.54mm_Vertical
J724: CH14 AUX14; PinHeader_1x03_P2.54mm_Vertical
J725: CH15 AUX15; PinHeader_1x03_P2.54mm_Vertical
R701, R702: 4.7k; R_0603_1608Metric
R703: 10k; R_0603_1608Metric
R712, R713, R714, R715, R716, R717, R718, R719, R720, R721, R722, R723, R724, R725: 220R; R_0603_1608Metric
U701: PCA9685PW; TSSOP-28_4.4x9.7mm_P0.65mm; MPN PCA9685PW,118
U703: MCP23017-E/SO; SOIC-28W_7.5x17.9mm_P1.27mm; MPN MCP23017-E/SO

Connections:
+3V3: C701.1, C703.1, J701.2, J702.2, J705.11, R701.1, R702.1, R703.1, U701.28 (VDD), U703.9 (VDD); also elsewhere on the board
/Expanders/LIM_DECK_DN: J703.2, U703.25 (GPA4)
/Expanders/LIM_DECK_UP: J703.1, U703.24 (GPA3)
/Expanders/MCP_GPB0: J705.1, U703.1 (GPB0)
/Expanders/MCP_GPB1: J705.2, U703.2 (GPB1)
/Expanders/MCP_GPB2: J705.3, U703.3 (GPB2)
/Expanders/MCP_GPB3: J705.4, U703.4 (GPB3)
/Expanders/MCP_GPB4: J705.5, U703.5 (GPB4)
/Expanders/MCP_GPB5: J705.6, U703.6 (GPB5)
/Expanders/MCP_GPB6: J705.7, U703.7 (GPB6)
/Expanders/MCP_GPB7: J705.8, U703.8 (GPB7)
/Expanders/MCP_RST: R703.2, U703.18 (~RESET)
/Expanders/SERVO_PWM2: R712.1, U701.8 (LED2)
/Expanders/SERVO_PWM3: R713.1, U701.9 (LED3)
/Expanders/SERVO_PWM4: R714.1, U701.10 (LED4)
/Expanders/SERVO_PWM5: R715.1, U701.11 (LED5)
/Expanders/SERVO_PWM6: R716.1, U701.12 (LED6)
/Expanders/SERVO_PWM7: R717.1, U701.13 (LED7)
/Expanders/SERVO_PWM8: R718.1, U701.15 (LED8)
/Expanders/SERVO_PWM9: R719.1, U701.16 (LED9)
/Expanders/SERVO_PWM10: R720.1, U701.17 (LED10)
/Expanders/SERVO_PWM11: R721.1, U701.18 (LED11)
/Expanders/SERVO_PWM12: R722.1, U701.19 (LED12)
/Expanders/SERVO_PWM13: R723.1, U701.20 (LED13)
/Expanders/SERVO_SIG2: J712.1, R712.2
/Expanders/SERVO_SIG3: J713.1, R713.2
/Expanders/SERVO_SIG4: J714.1, R714.2
/Expanders/SERVO_SIG5: J715.1, R715.2
/Expanders/SERVO_SIG6: J716.1, R716.2
/Expanders/SERVO_SIG7: J717.1, R717.2
/Expanders/SERVO_SIG8: J718.1, R718.2
/Expanders/SERVO_SIG9: J719.1, R719.2
/Expanders/SERVO_SIG10: J720.1, R720.2
/Expanders/SERVO_SIG11: J721.1, R721.2
/Expanders/SERVO_SIG12: J722.1, R722.2
/Expanders/SERVO_SIG13: J723.1, R723.2
/Expanders/SERVO_SIG14: J724.1, R724.2
/Expanders/SERVO_SIG15: J725.1, R725.2
/Expanders/TURRET_CENTER: J704.1, U703.26 (GPA5)
DRV_nFAULT: U703.22 (GPA1); also elsewhere on the board
DRV_nSLEEP: U703.21 (GPA0); also elsewhere on the board
GND: C701.2, C703.2, J701.1, J701.MP (MountPin), J702.1, J702.MP (MountPin), J703.3, J704.2, J705.12, J712.3, J713.3, J714.3, J715.3, J716.3, J717.3, J718.3, J719.3, J720.3, J721.3, J722.3, J723.3, J724.3, J725.3, U701.1 (A0), U701.2 (A1), U701.3 (A2), U701.4 (A3), U701.5 (A4), U701.14 (VSS), U701.23 (~OE), U701.24 (A5), U701.25 (EXTCLK), U703.10 (VSS), U703.15 (A0), U703.16 (A1), U703.17 (A2); also elsewhere on the board
I2C_SCL: J701.4, J702.4, R702.2, U701.26 (SCL), U703.12 (SCK); also elsewhere on the board
I2C_SDA: J701.3, J702.3, R701.2, U701.27 (SDA), U703.13 (SDA); also elsewhere on the board
SD_DET: U703.23 (GPA2); also elsewhere on the board
SERVO_PWM14: R724.1, U701.21 (LED14); also elsewhere on the board
SERVO_PWM15: R725.1, U701.22 (LED15); also elsewhere on the board
TUR_ELEV_SERVO: U701.7 (LED1); also elsewhere on the board
TUR_ROT_SERVO: U701.6 (LED0); also elsewhere on the board
TUR_nFAULT: U703.27 (GPA6); also elsewhere on the board
TUR_nSLEEP: U703.28 (GPA7); also elsewhere on the board
VSERVO: J712.2, J713.2, J714.2, J715.2, J716.2, J717.2, J718.2, J719.2, J720.2, J721.2, J722.2, J723.2, J724.2, J725.2; also elsewhere on the board

Notes on the sheet:
I2C BUS (3.3V) PCA9685 0x40 / PCA9685 0x41 / MCP23017 0x20
Qwiic pinout: 1 GND, 2 3V3, 3 SDA, 4 SCL. Gyro (MPU6050/BNO085) etc. plug in here.
MCP23017 (0x20) digital I/O
Limit switches: switch to GND, use MCP internal 100k pull-ups.
GPA0/GPA1: drive DRV nSLEEP/nFAULT. GPA7/GPA6: turret TUR_nSLEEP/TUR_nFAULT.
GPA7/GPB7: OUTPUT ONLY on current MCP23017 silicon.
Inputs are 3.3V max - no 5V signals on J705.
PCA9685 #1 (0x40) SERVOS 50Hz
Servo headers: S / + / - (signal on top). + = VSERVO (5V or 6V jumper)
CH0 = turret rotation servo, CH1 = gun elevation servo (turret sheet ports)
