yuanhaozhe2022-eng/OpenTank_Public/tank_board.kicad_pcb

## KiCad design tank_board.kicad_pcb (continued)

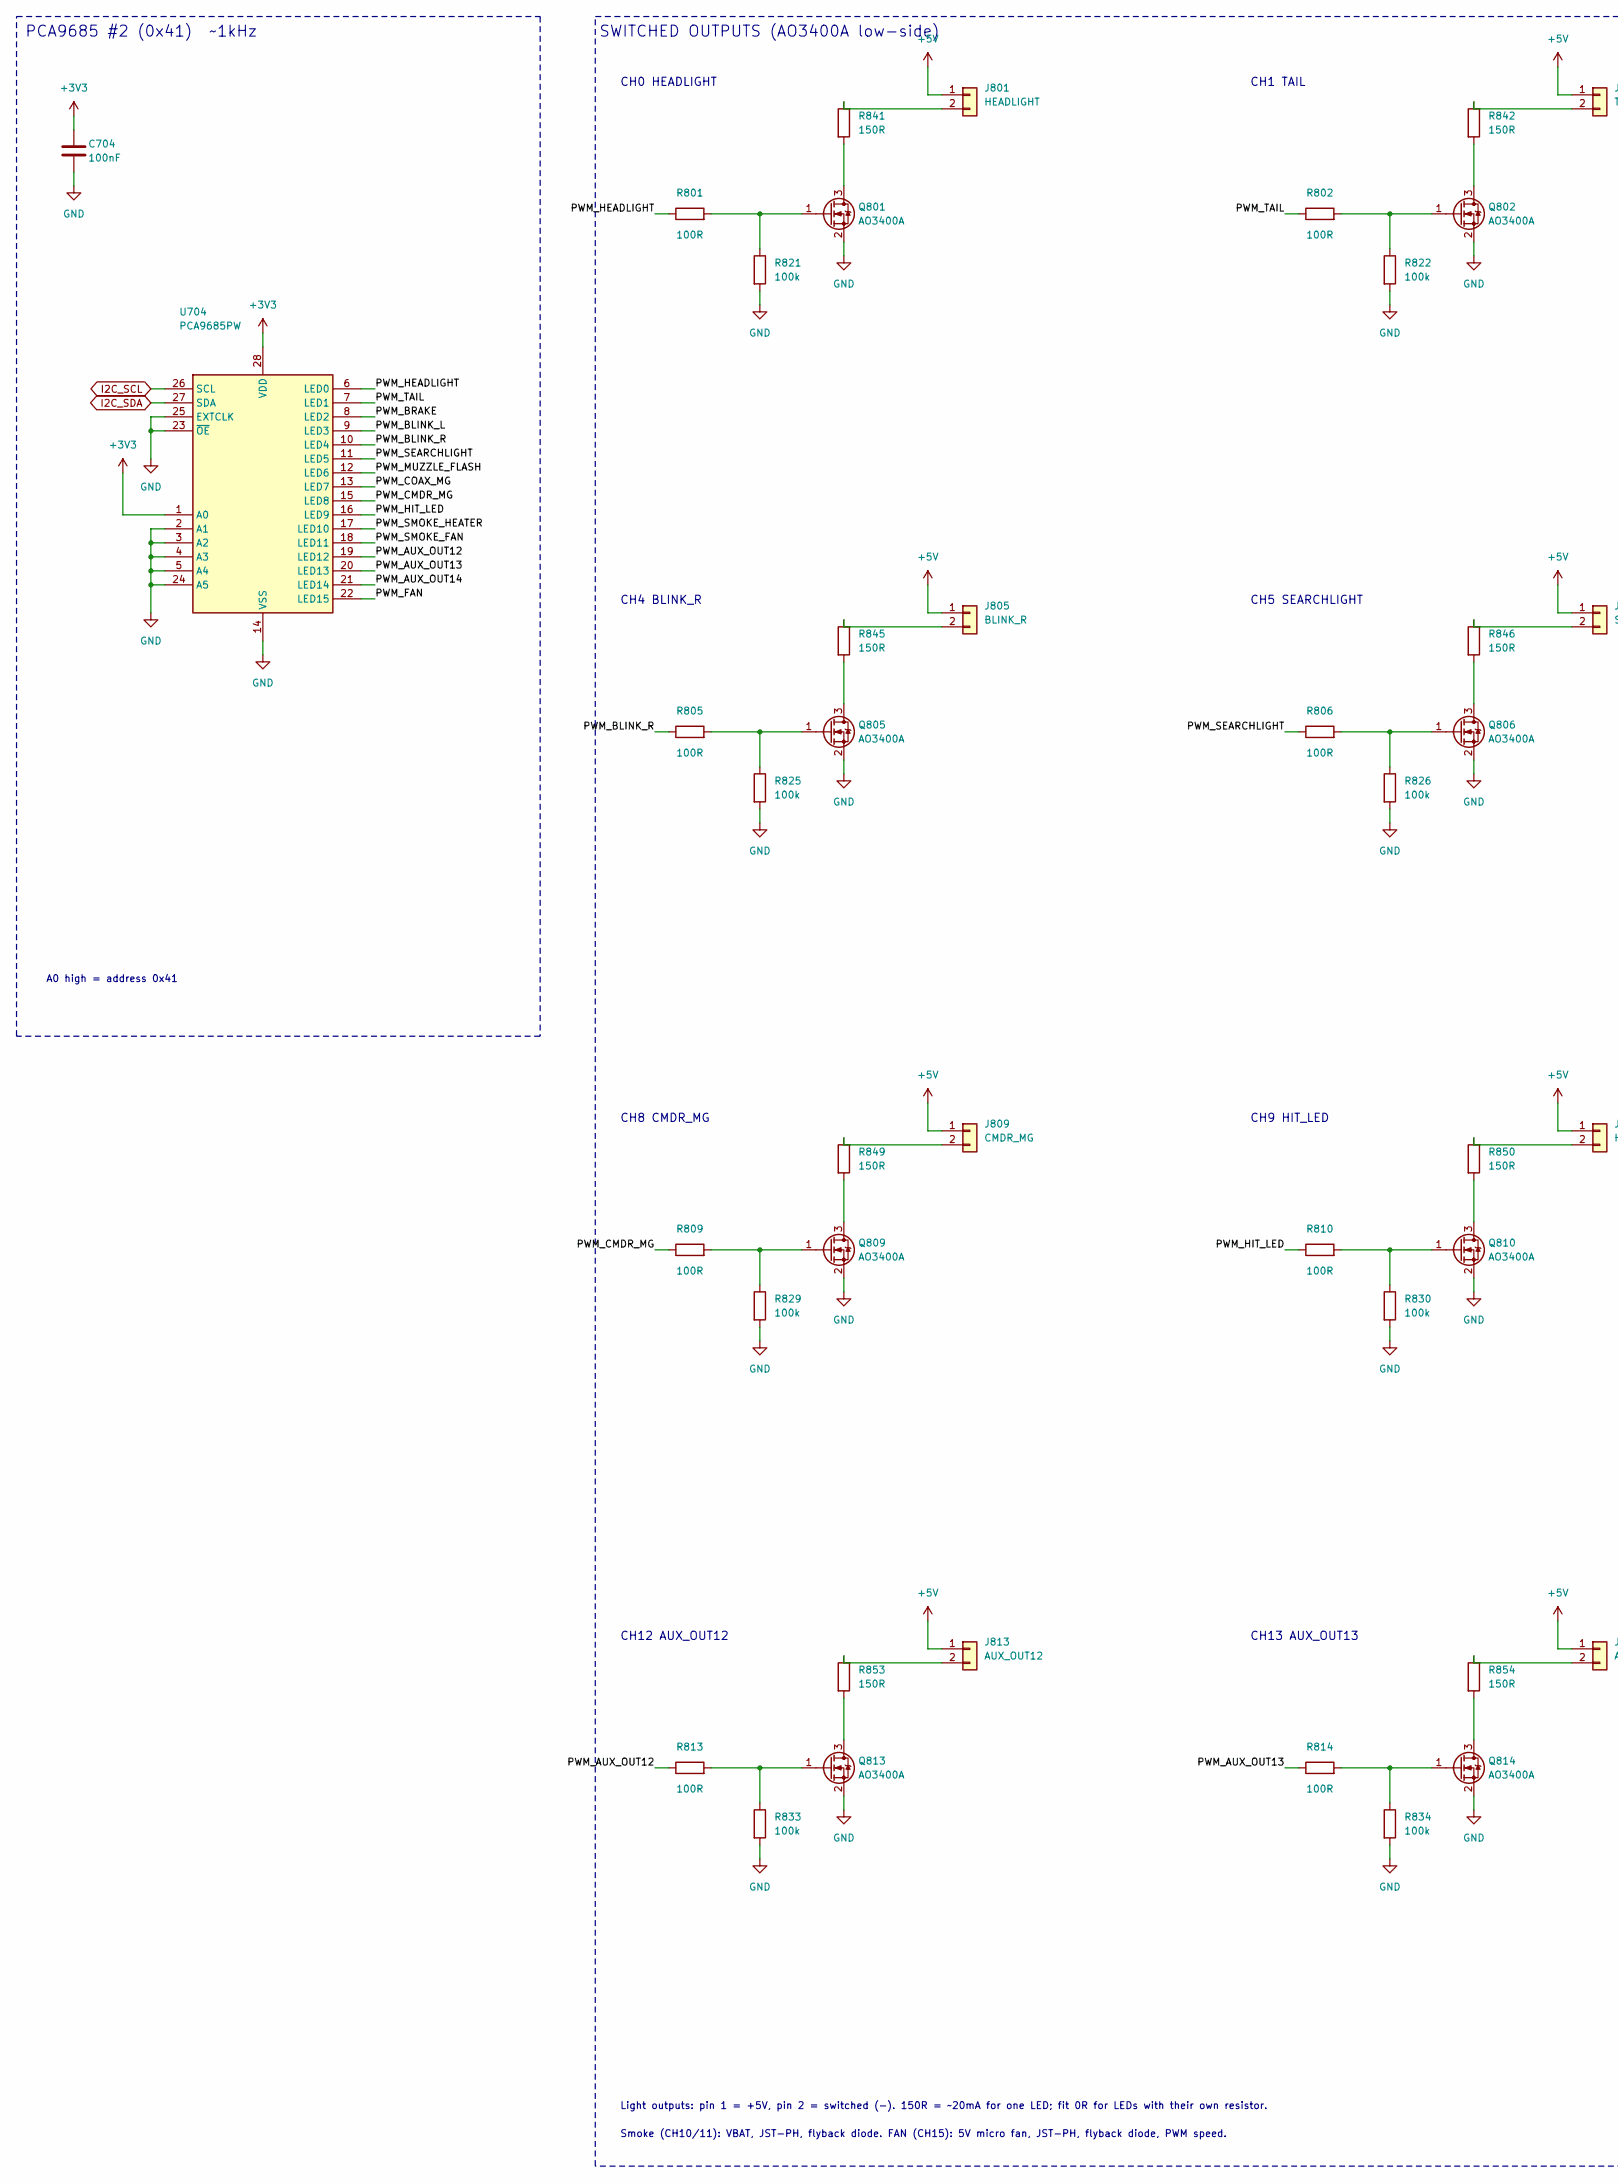
[picture p10: schematic lights.kicad_sch, Tank Board - PCA9685 #2 lights + smoke outputs, part in row 1, column 1]

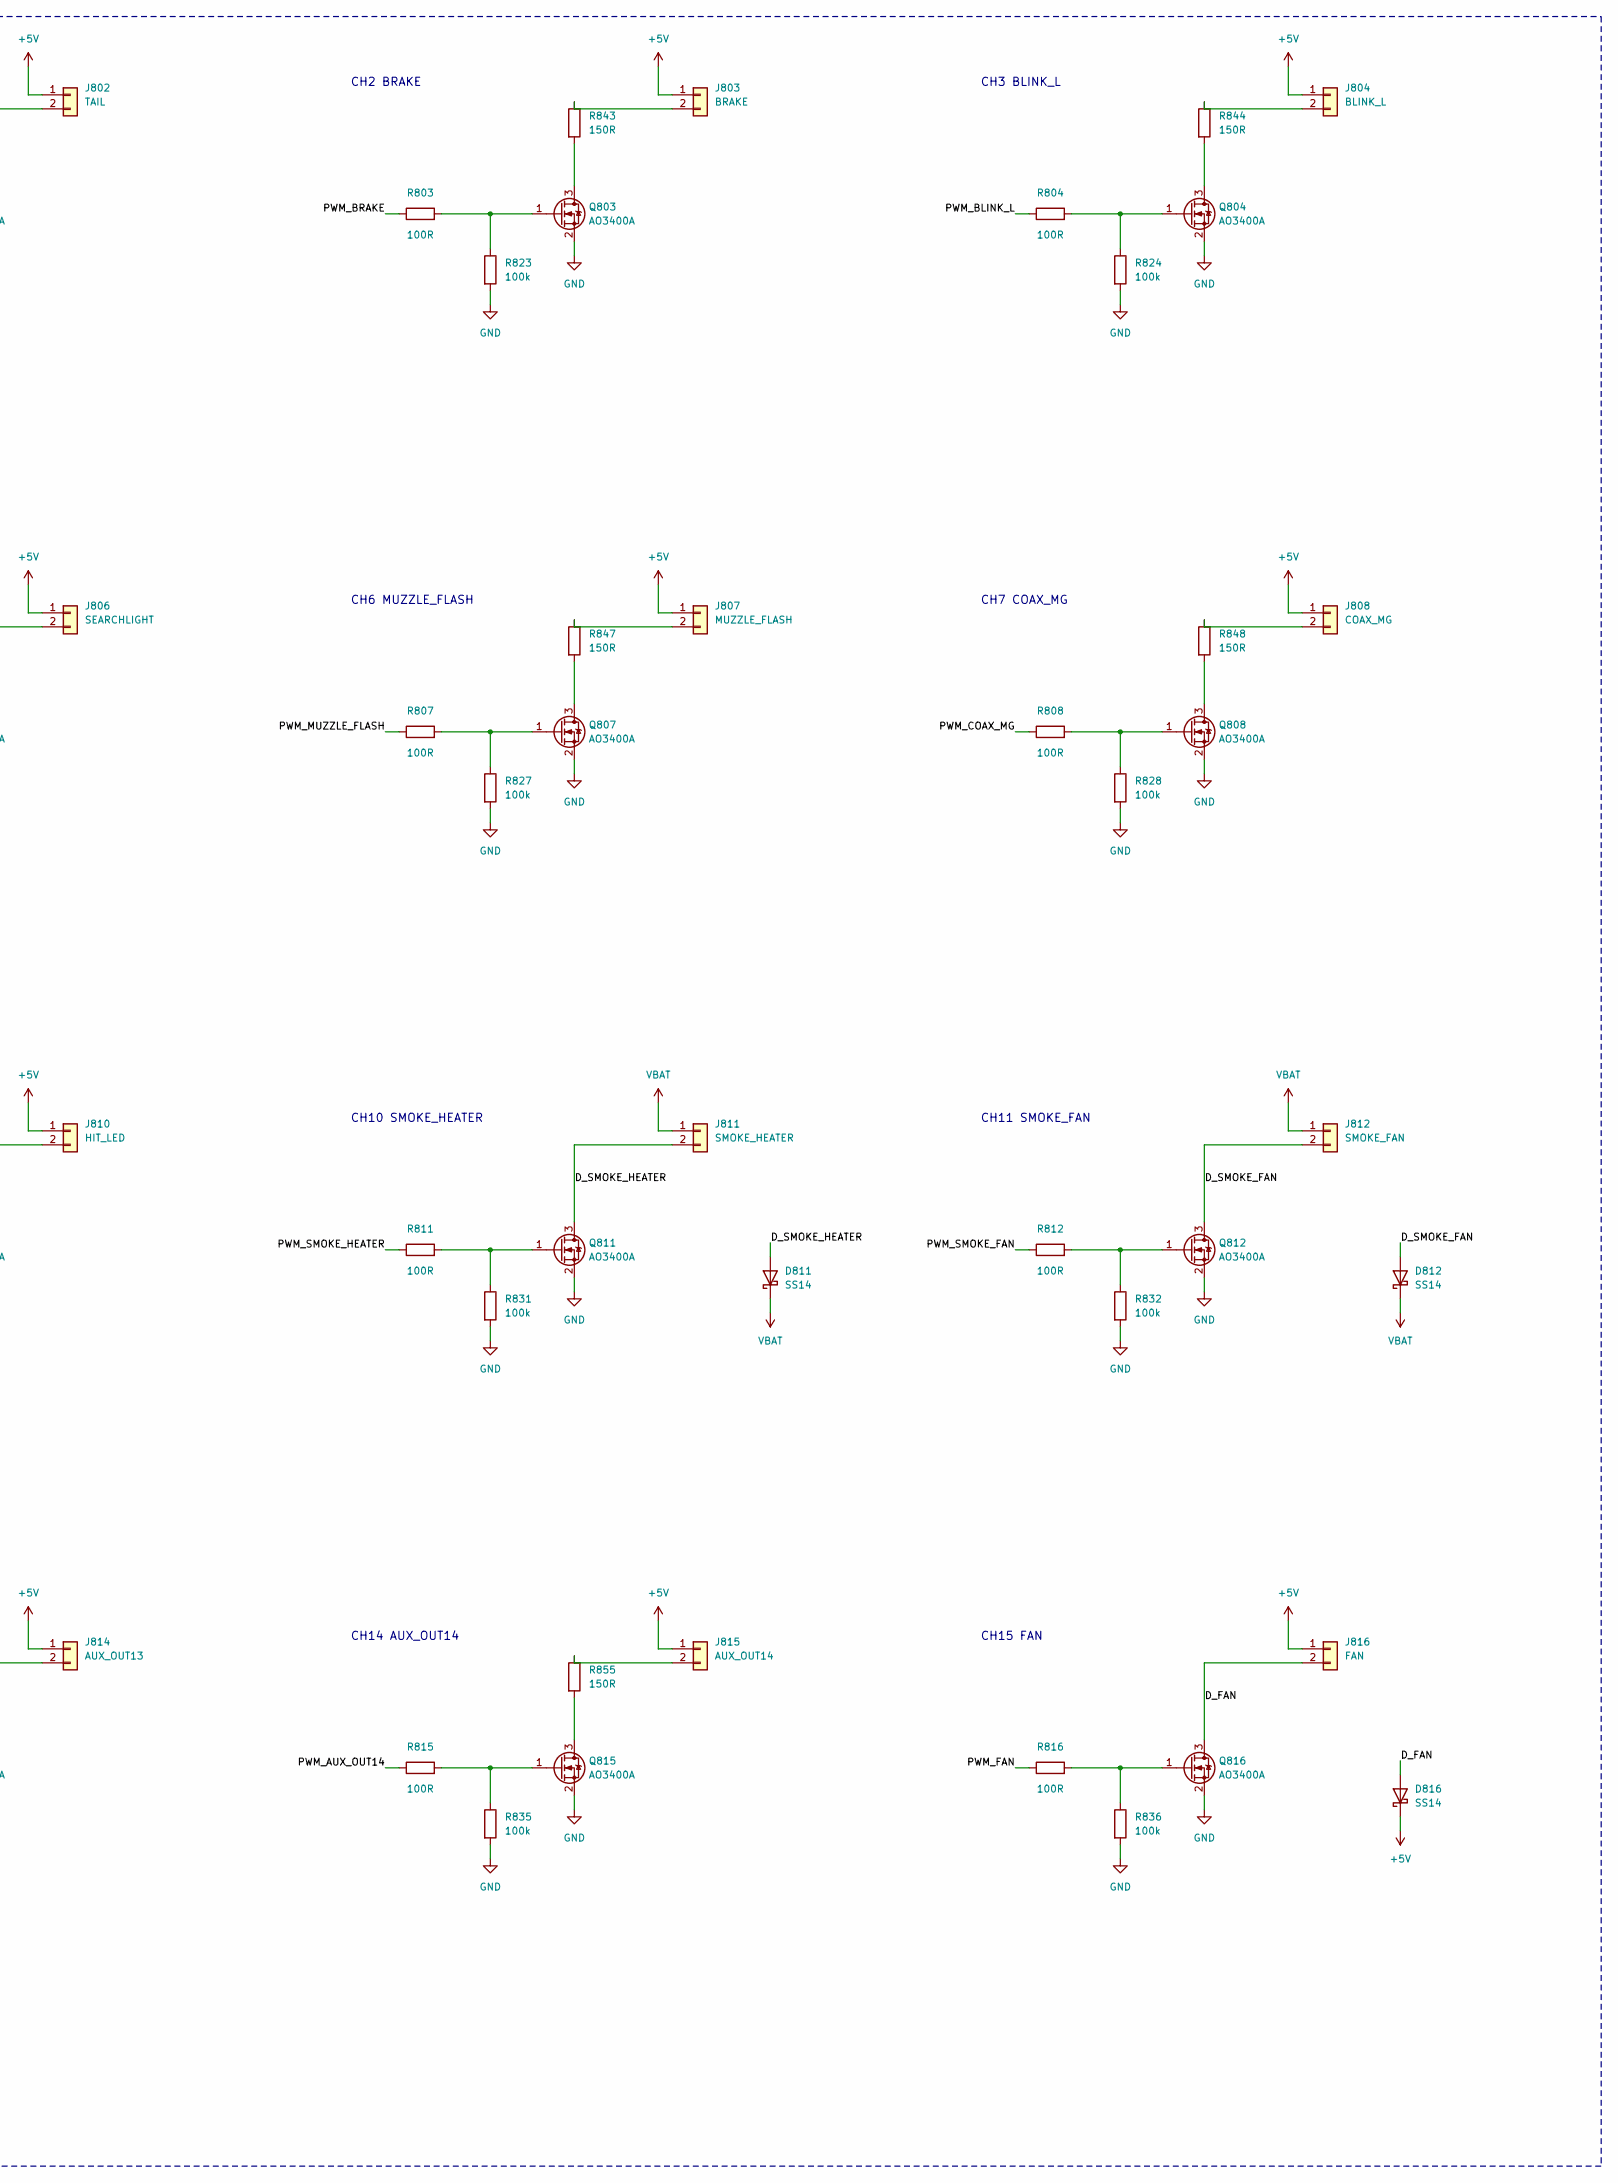
[picture p11: schematic lights.kicad_sch, Tank Board - PCA9685 #2 lights + smoke outputs, part in row 1, column 2]

Parts:
C704: 100nF; C_0603_1608Metric
D811, D812, D816: SS14; D_SOD-123F; MPN SS14 / B140
J801: HEADLIGHT; PinHeader_1x02_P2.54mm_Vertical
J802: TAIL; PinHeader_1x02_P2.54mm_Vertical
J803: BRAKE; PinHeader_1x02_P2.54mm_Vertical
J804: BLINK_L; PinHeader_1x02_P2.54mm_Vertical
J805: BLINK_R; PinHeader_1x02_P2.54mm_Vertical
J806: SEARCHLIGHT; PinHeader_1x02_P2.54mm_Vertical
J807: MUZZLE_FLASH; PinHeader_1x02_P2.54mm_Vertical
J808: COAX_MG; PinHeader_1x02_P2.54mm_Vertical
J809: CMDR_MG; PinHeader_1x02_P2.54mm_Vertical
J810: HIT_LED; PinHeader_1x02_P2.54mm_Vertical
J811: SMOKE_HEATER; JST_PH_B2B-PH-K_1x02_P2.00mm_Vertical
J812: SMOKE_FAN; JST_PH_B2B-PH-K_1x02_P2.00mm_Vertical
J813: AUX_OUT12; PinHeader_1x02_P2.54mm_Vertical
J814: AUX_OUT13; PinHeader_1x02_P2.54mm_Vertical
J815: AUX_OUT14; PinHeader_1x02_P2.54mm_Vertical
J816: FAN; JST_PH_B2B-PH-K_1x02_P2.00mm_Vertical
Q801, Q802, Q803, Q804, Q805, Q806, Q807, Q808, Q809, Q810, Q811, Q812, Q813, Q814, Q815, Q816: AO3400A; SOT-23; MPN AO3400A
R801, R802, R803, R804, R805, R806, R807, R808, R809, R810, R811, R812, R813, R814, R815, R816: 100R; R_0603_1608Metric
R821, R822, R823, R824, R825, R826, R827, R828, R829, R830, R831, R832, R833, R834, R835, R836: 100k; R_0603_1608Metric
R841, R842, R843, R844, R845, R846, R847, R848, R849, R850, R853, R854, R855: 150R; R_0603_1608Metric
U704: PCA9685PW; TSSOP-28_4.4x9.7mm_P0.65mm; MPN PCA9685PW,118

Connections:
+3V3: C704.1, U704.1 (A0), U704.28 (VDD); also elsewhere on the board
+5V: D816.1 (K), J801.1, J802.1, J803.1, J804.1, J805.1, J806.1, J807.1, J808.1, J809.1, J810.1, J813.1, J814.1, J815.1, J816.1; also elsewhere on the board
/Lights/D_FAN: D816.2 (A), J816.2, Q816.3 (D)
/Lights/D_SMOKE_FAN: D812.2 (A), J812.2, Q812.3 (D)
/Lights/D_SMOKE_HEATER: D811.2 (A), J811.2, Q811.3 (D)
/Lights/PWM_AUX_OUT12: R813.1, U704.19 (LED12)
/Lights/PWM_AUX_OUT13: R814.1, U704.20 (LED13)
/Lights/PWM_AUX_OUT14: R815.1, U704.21 (LED14)
/Lights/PWM_BLINK_L: R804.1, U704.9 (LED3)
/Lights/PWM_BLINK_R: R805.1, U704.10 (LED4)
/Lights/PWM_BRAKE: R803.1, U704.8 (LED2)
/Lights/PWM_CMDR_MG: R809.1, U704.15 (LED8)
/Lights/PWM_COAX_MG: R808.1, U704.13 (LED7)
/Lights/PWM_FAN: R816.1, U704.22 (LED15)
/Lights/PWM_HEADLIGHT: R801.1, U704.6 (LED0)
/Lights/PWM_HIT_LED: R810.1, U704.16 (LED9)
/Lights/PWM_MUZZLE_FLASH: R807.1, U704.12 (LED6)
/Lights/PWM_SEARCHLIGHT: R806.1, U704.11 (LED5)
/Lights/PWM_SMOKE_FAN: R812.1, U704.18 (LED11)
/Lights/PWM_SMOKE_HEATER: R811.1, U704.17 (LED10)
/Lights/PWM_TAIL: R802.1, U704.7 (LED1)
GND: C704.2, Q801.2 (S), Q802.2 (S), Q803.2 (S), Q804.2 (S), Q805.2 (S), Q806.2 (S), Q807.2 (S), Q808.2 (S), Q809.2 (S), Q810.2 (S), Q811.2 (S), Q812.2 (S), Q813.2 (S), Q814.2 (S), Q815.2 (S), Q816.2 (S), R821.2, R822.2, R823.2, R824.2, R825.2, R826.2, R827.2, R828.2, R829.2, R830.2, R831.2, R832.2, R833.2, R834.2, R835.2, R836.2, U704.2 (A1), U704.3 (A2), U704.4 (A3), U704.5 (A4), U704.14 (VSS), U704.23 (~OE), U704.24 (A5), U704.25 (EXTCLK); also elsewhere on the board
I2C_SCL: U704.26 (SCL); also elsewhere on the board
I2C_SDA: U704.27 (SDA); also elsewhere on the board
unnamed: J801.2, R841.1
unnamed: J802.2, R842.1
unnamed: J803.2, R843.1
unnamed: J804.2, R844.1
unnamed: J805.2, R845.1
unnamed: J806.2, R846.1
unnamed: J807.2, R847.1
unnamed: J808.2, R848.1
unnamed: J809.2, R849.1
unnamed: J810.2, R850.1
unnamed: J813.2, R853.1
unnamed: J814.2, R854.1
unnamed: J815.2, R855.1
unnamed: Q801.3 (D), R841.2
unnamed: Q801.1 (G), R801.2, R821.1
unnamed: Q802.3 (D), R842.2
unnamed: Q802.1 (G), R802.2, R822.1
unnamed: Q803.3 (D), R843.2
unnamed: Q803.1 (G), R803.2, R823.1
unnamed: Q804.3 (D), R844.2
unnamed: Q804.1 (G), R804.2, R824.1
unnamed: Q805.3 (D), R845.2
unnamed: Q805.1 (G), R805.2, R825.1
unnamed: Q806.3 (D), R846.2
unnamed: Q806.1 (G), R806.2, R826.1
unnamed: Q807.3 (D), R847.2
unnamed: Q807.1 (G), R807.2, R827.1
unnamed: Q808.3 (D), R848.2
unnamed: Q808.1 (G), R808.2, R828.1
unnamed: Q809.3 (D), R849.2
unnamed: Q809.1 (G), R809.2, R829.1
unnamed: Q810.3 (D), R850.2
unnamed: Q810.1 (G), R810.2, R830.1
unnamed: Q811.1 (G), R811.2, R831.1
unnamed: Q812.1 (G), R812.2, R832.1
unnamed: Q813.3 (D), R853.2
unnamed: Q813.1 (G), R813.2, R833.1
unnamed: Q814.3 (D), R854.2
unnamed: Q814.1 (G), R814.2, R834.1
unnamed: Q815.3 (D), R855.2
unnamed: Q815.1 (G), R815.2, R835.1
unnamed: Q816.1 (G), R816.2, R836.1
VBAT: D811.1 (K), D812.1 (K), J811.1, J812.1; also elsewhere on the board

Notes on the sheet:
PCA9685 #2 (0x41) ~1kHz
A0 high = address 0x41
SWITCHED OUTPUTS (AO3400A low-side)
CH0 HEADLIGHT
CH1 TAIL
CH2 BRAKE
CH3 BLINK_L
CH4 BLINK_R
CH5 SEARCHLIGHT
CH6 MUZZLE_FLASH
CH7 COAX_MG
CH8 CMDR_MG
CH9 HIT_LED
CH10 SMOKE_HEATER
CH11 SMOKE_FAN
CH12 AUX_OUT12
CH13 AUX_OUT13
CH14 AUX_OUT14
CH15 FAN
Light outputs: pin 1 = +5V, pin 2 = switched (-). 150R = ~20mA for one LED; fit 0R for LEDs with their own resistor.
Smoke (CH10/11): VBAT, JST-PH, flyback diode. FAN (CH15): 5V micro fan, JST-PH, flyback diode, PWM speed.

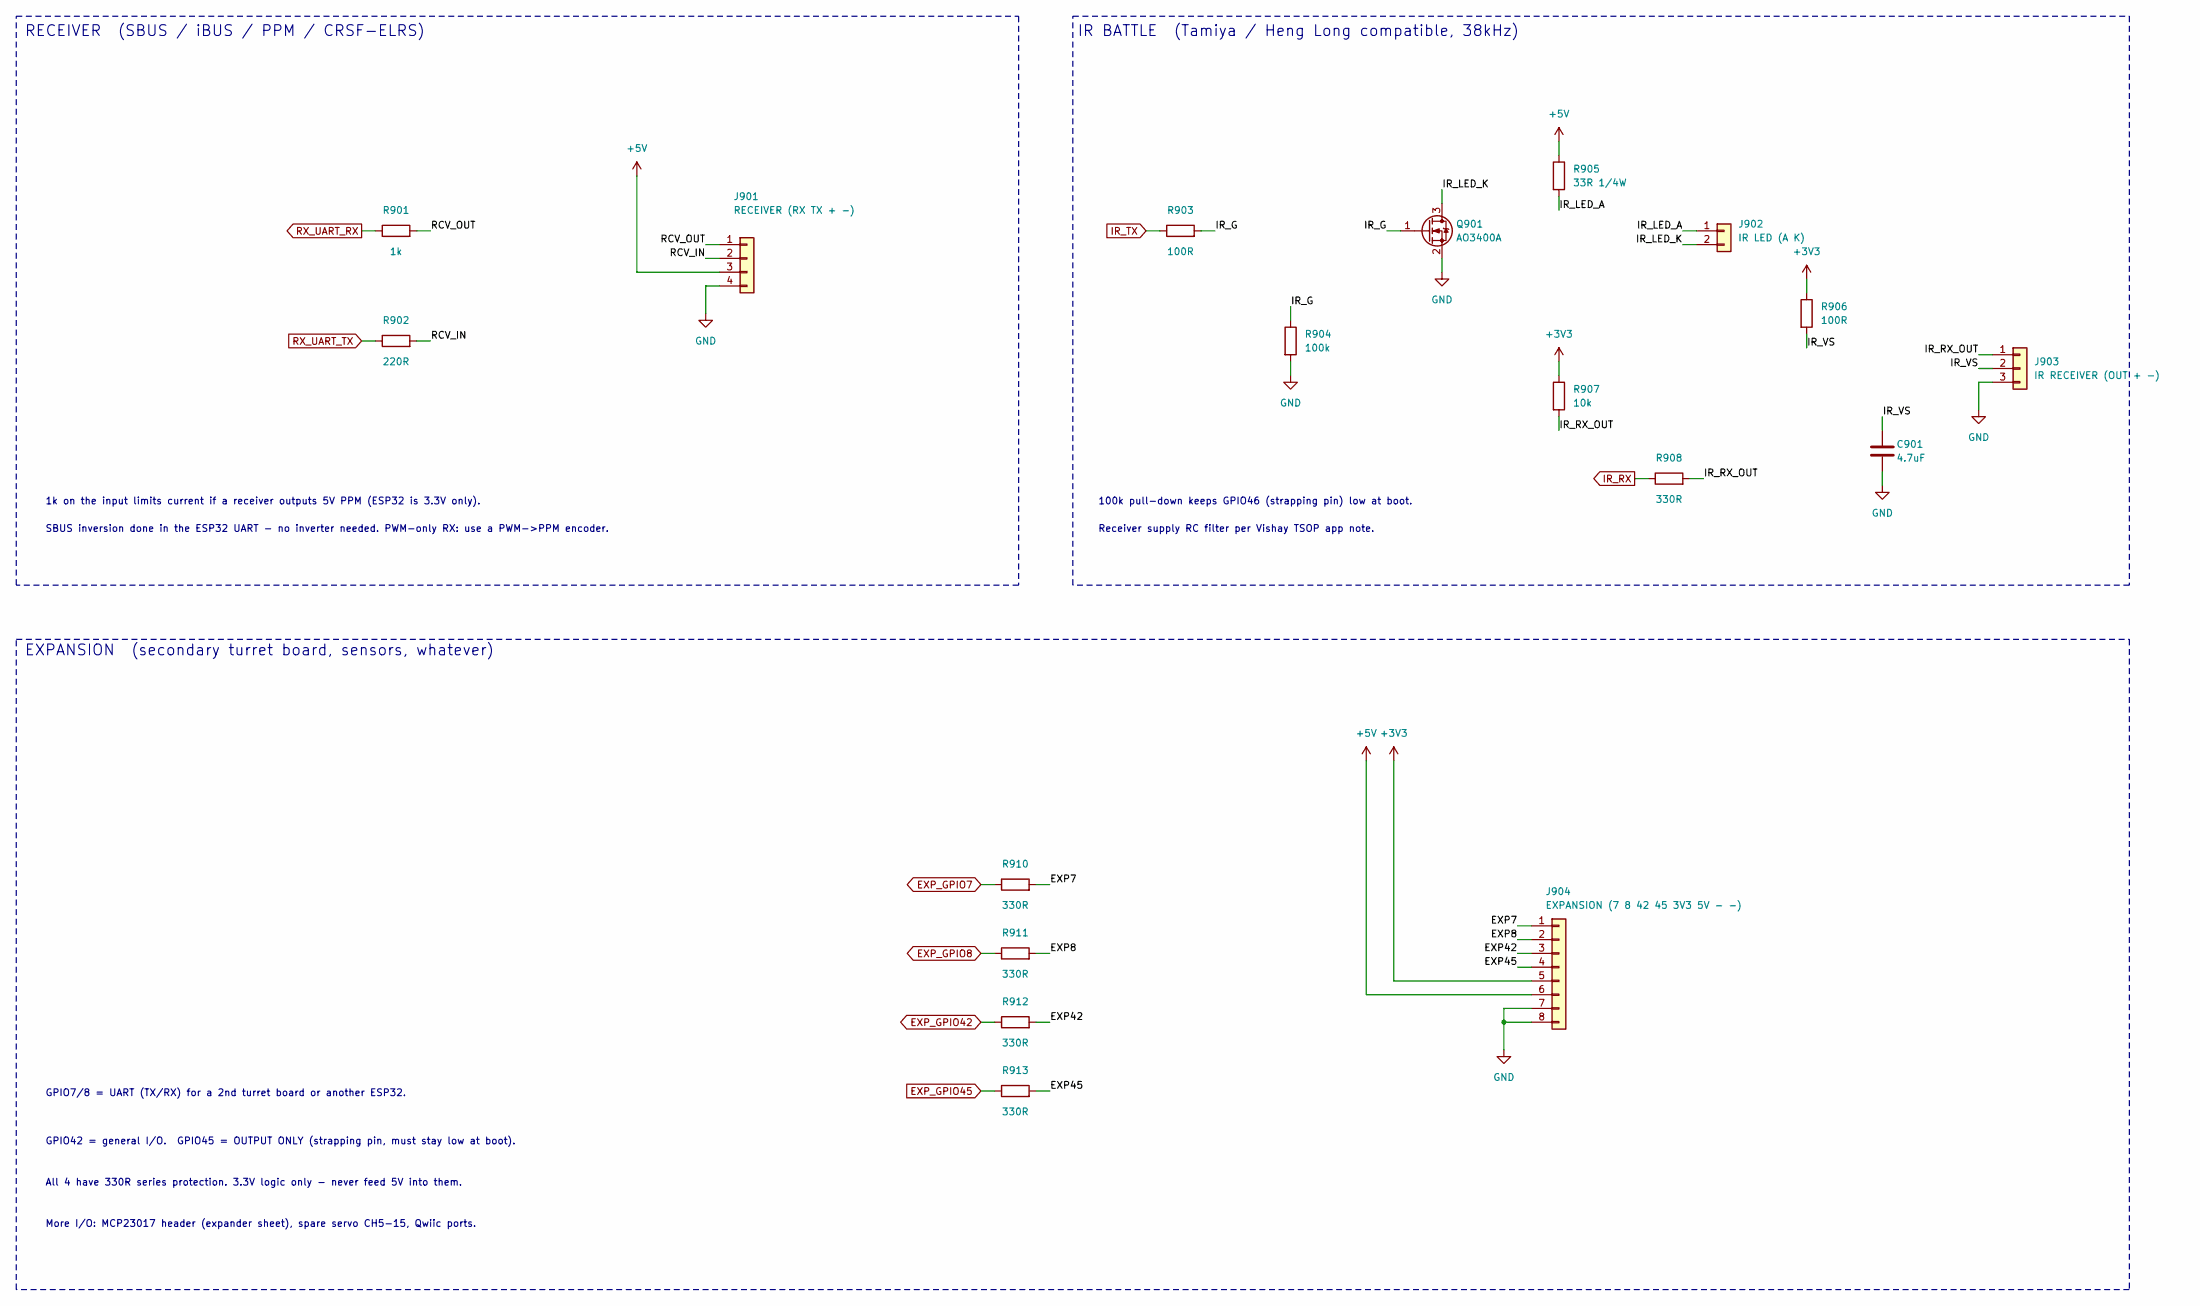
[picture p12: schematic io.kicad_sch, Tank Board - Receiver, IR battle, expansion]

Parts:
C901: 4.7uF; C_0805_2012Metric
J901: RECEIVER (RX TX + -); PinHeader_1x04_P2.54mm_Vertical
J902: IR LED (A K); PinHeader_1x02_P2.54mm_Vertical
J903: IR RECEIVER (OUT + -); PinHeader_1x03_P2.54mm_Vertical
J904: EXPANSION (7 8 42 45 3V3 5V - -); PinHeader_2x04_P2.54mm_Vertical
Q901: AO3400A; SOT-23; MPN AO3400A
R901: 1k; R_0603_1608Metric
R902: 220R; R_0603_1608Metric
R903, R906: 100R; R_0603_1608Metric
R904: 100k; R_0603_1608Metric
R905: 33R 1/4W; R_1206_3216Metric
R907: 10k; R_0603_1608Metric
R908, R910, R911, R912, R913: 330R; R_0603_1608Metric

Connections:
+3V3: J904.5, R906.1, R907.1; also elsewhere on the board
+5V: J901.3, J904.6, R905.1; also elsewhere on the board
/Receiver_IR_Exp/EXP7: J904.1, R910.2
/Receiver_IR_Exp/EXP8: J904.2, R911.2
/Receiver_IR_Exp/EXP42: J904.3, R912.2
/Receiver_IR_Exp/EXP45: J904.4, R913.2
/Receiver_IR_Exp/IR_G: Q901.1 (G), R903.2, R904.1
/Receiver_IR_Exp/IR_LED_A: J902.1, R905.2
/Receiver_IR_Exp/IR_LED_K: J902.2, Q901.3 (D)
/Receiver_IR_Exp/IR_RX_OUT: J903.1, R907.2, R908.2
/Receiver_IR_Exp/IR_VS: C901.1, J903.2, R906.2
/Receiver_IR_Exp/RCV_IN: J901.2, R902.2
/Receiver_IR_Exp/RCV_OUT: J901.1, R901.2
EXP_GPIO7: R910.1; also elsewhere on the board
EXP_GPIO8: R911.1; also elsewhere on the board
EXP_GPIO42: R912.1; also elsewhere on the board
EXP_GPIO45: R913.1; also elsewhere on the board
GND: C901.2, J901.4, J903.3, J904.7, J904.8, Q901.2 (S), R904.2; also elsewhere on the board
IR_RX: R908.1; also elsewhere on the board
IR_TX: R903.1; also elsewhere on the board
RX_UART_RX: R901.1; also elsewhere on the board
RX_UART_TX: R902.1; also elsewhere on the board

Notes on the sheet:
RECEIVER (SBUS / iBUS / PPM / CRSF-ELRS)
1k on the input limits current if a receiver outputs 5V PPM (ESP32 is 3.3V only).
SBUS inversion done in the ESP32 UART - no inverter needed. PWM-only RX: use a PWM->PPM encoder.
IR BATTLE (Tamiya / Heng Long compatible, 38kHz)
100k pull-down keeps GPIO46 (strapping pin) low at boot.
Receiver supply RC filter per Vishay TSOP app note.
EXPANSION (secondary turret board, sensors, whatever)
GPIO7/8 = UART (TX/RX) for a 2nd turret board or another ESP32.
GPIO42 = general I/O. GPIO45 = OUTPUT ONLY (strapping pin, must stay low at boot).
All 4 have 330R series protection. 3.3V logic only - never feed 5V into them.
More I/O: MCP23017 header (expander sheet), spare servo CH5-15, Qwiic ports.

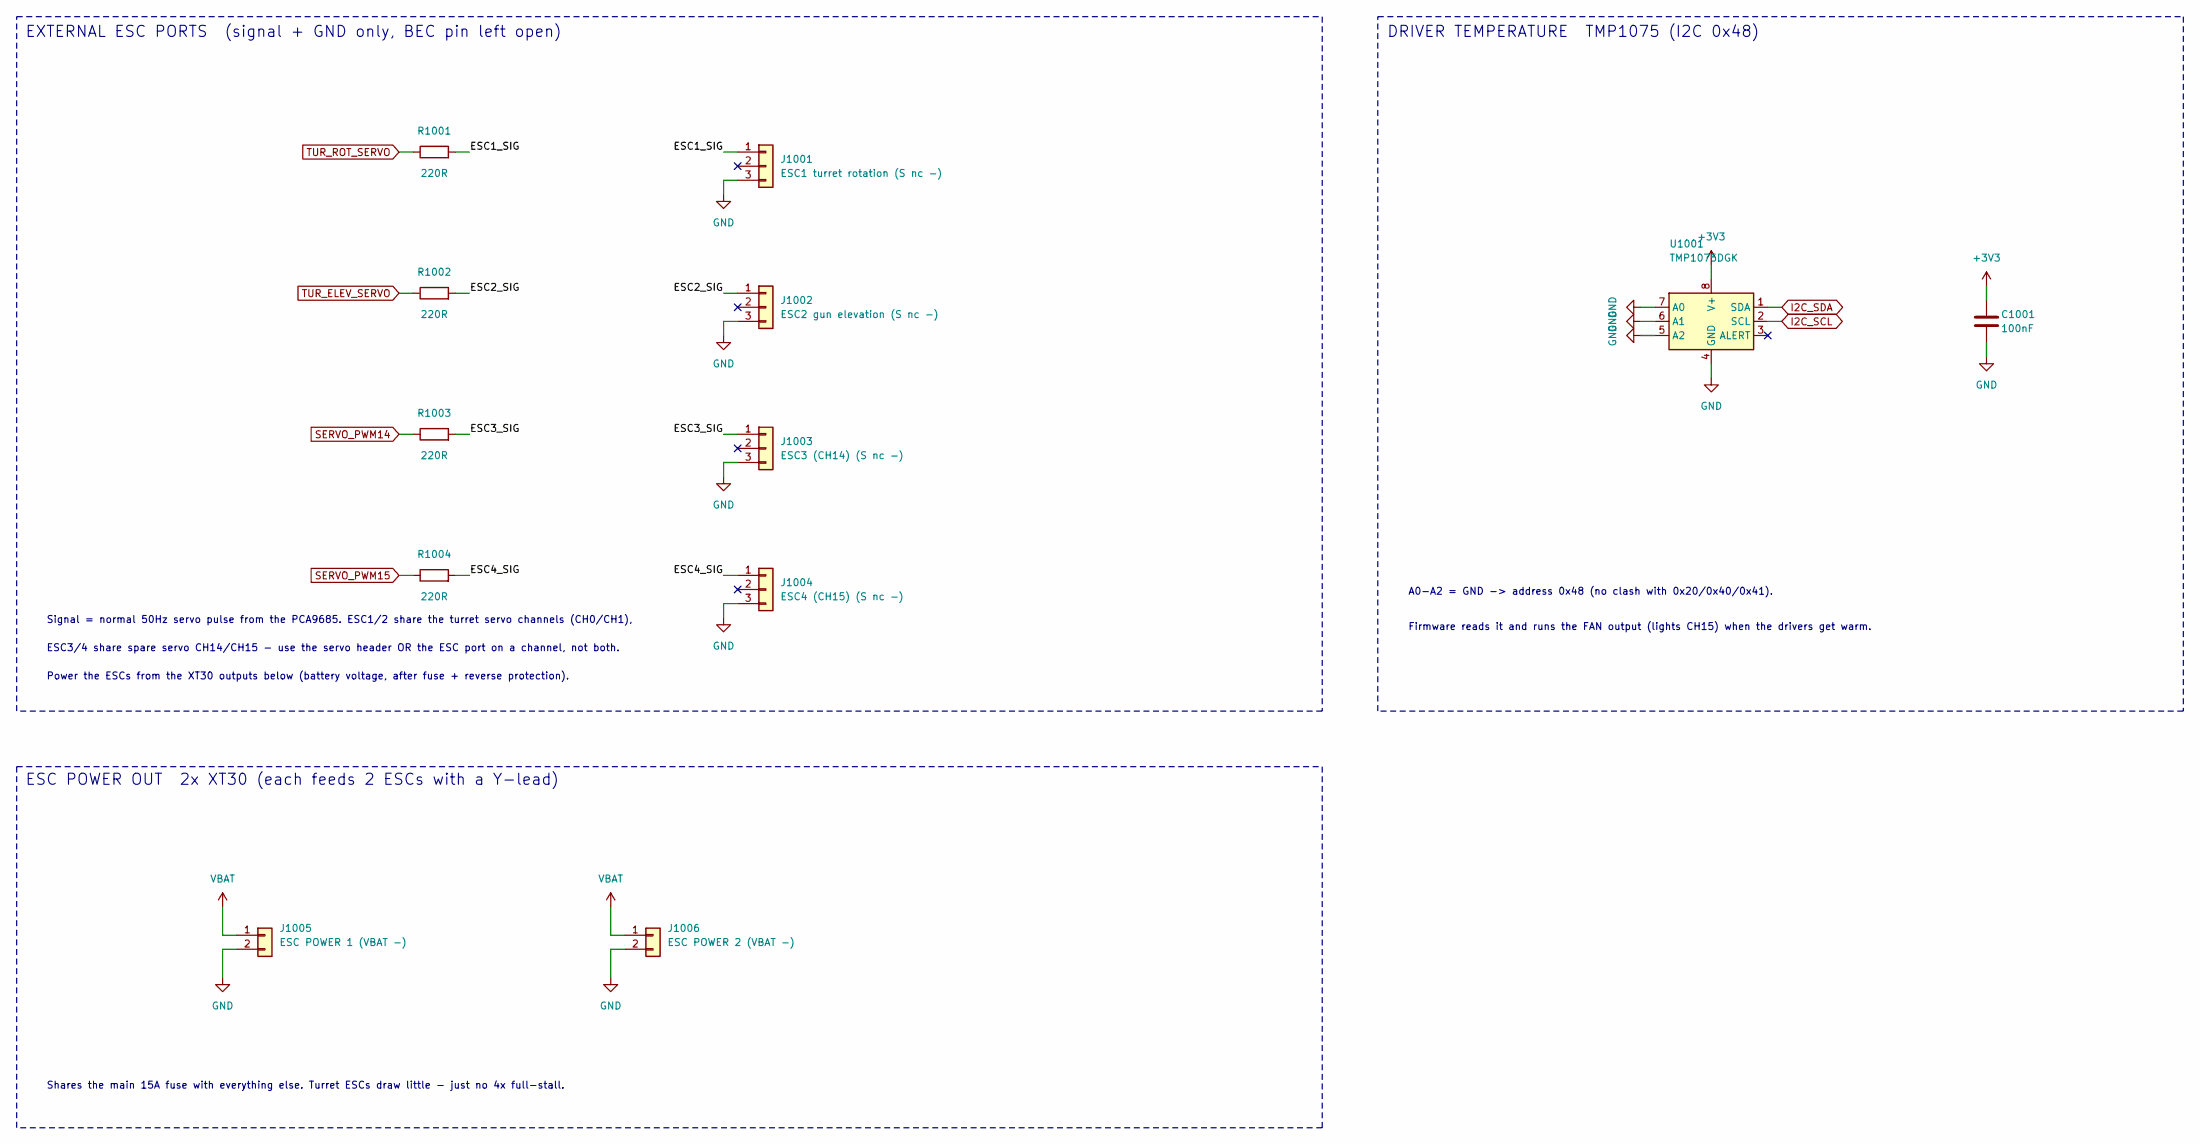
[picture p13: schematic extras.kicad_sch, Tank Board - External ESC ports, ESC power, temperature sen…]

Parts:
C1001: 100nF; C_0603_1608Metric
J1001: ESC1 turret rotation (S nc -); PinHeader_1x03_P2.54mm_Vertical
J1002: ESC2 gun elevation (S nc -); PinHeader_1x03_P2.54mm_Vertical
J1003: ESC3 (CH14) (S nc -); PinHeader_1x03_P2.54mm_Vertical
J1004: ESC4 (CH15) (S nc -); PinHeader_1x03_P2.54mm_Vertical
J1005: ESC POWER 1 (VBAT -); AMASS_XT30U-F_1x02_P5.0mm_Vertical; MPN AMASS XT30U-F
J1006: ESC POWER 2 (VBAT -); AMASS_XT30U-F_1x02_P5.0mm_Vertical; MPN AMASS XT30U-F
R1001, R1002, R1003, R1004: 220R; R_0603_1608Metric
U1001: TMP1075DGK; VSSOP-8_3.0x3.0mm_P0.65mm; MPN TMP1075DGKR

Connections:
+3V3: C1001.1, U1001.8 (V+); also elsewhere on the board
/Extras/ESC1_SIG: J1001.1, R1001.2
/Extras/ESC2_SIG: J1002.1, R1002.2
/Extras/ESC3_SIG: J1003.1, R1003.2
/Extras/ESC4_SIG: J1004.1, R1004.2
GND: C1001.2, J1001.3, J1002.3, J1003.3, J1004.3, J1005.2, J1006.2, U1001.4 (GND), U1001.5 (A2), U1001.6 (A1), U1001.7 (A0); also elsewhere on the board
I2C_SCL: U1001.2 (SCL); also elsewhere on the board
I2C_SDA: U1001.1 (SDA); also elsewhere on the board
SERVO_PWM14: R1003.1; also elsewhere on the board
SERVO_PWM15: R1004.1; also elsewhere on the board
TUR_ELEV_SERVO: R1002.1; also elsewhere on the board
TUR_ROT_SERVO: R1001.1; also elsewhere on the board
VBAT: J1005.1, J1006.1; also elsewhere on the board

Notes on the sheet:
EXTERNAL ESC PORTS (signal + GND only, BEC pin left open)
Signal = normal 50Hz servo pulse from the PCA9685. ESC1/2 share the turret servo channels (CH0/CH1),
ESC3/4 share spare servo CH14/CH15 - use the servo header OR the ESC port on a channel, not both.
Power the ESCs from the XT30 outputs below (battery voltage, after fuse + reverse protection).
ESC POWER OUT 2x XT30 (each feeds 2 ESCs with a Y-lead)
Shares the main 15A fuse with everything else. Turret ESCs draw little - just no 4x full-stall.
DRIVER TEMPERATURE TMP1075 (I2C 0x48)
A0-A2 = GND -> address 0x48 (no clash with 0x20/0x40/0x41).
Firmware reads it and runs the FAN output (lights CH15) when the drivers get warm.

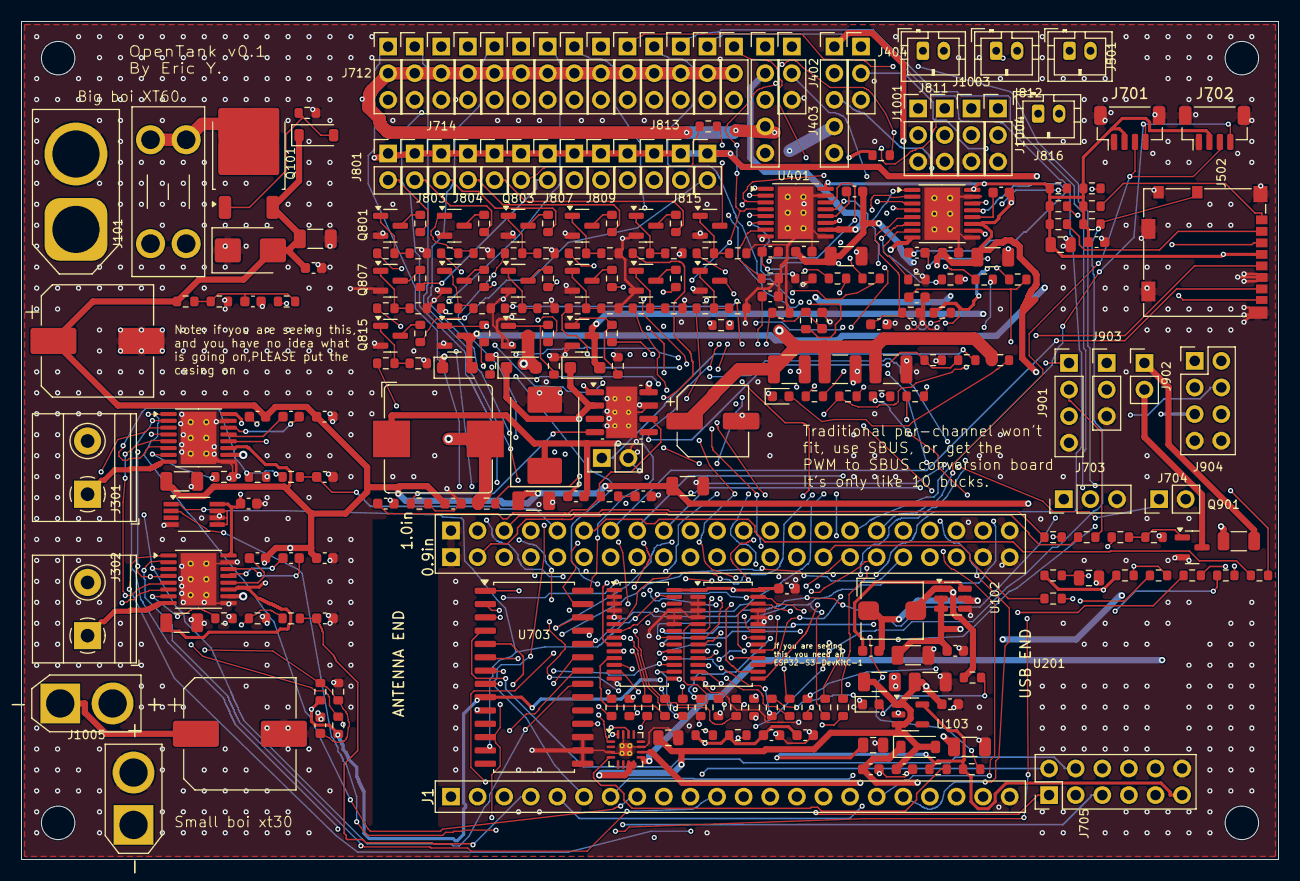
[picture p14: board tank_board.kicad_pcb from above]

Board: 4 copper layers, 120.0 x 80.0 mm, 276 parts (0 on the bottom side), 214 nets.
