yuanhaozhe2022-eng/OpenTank_Public/(commit log)

2026-10-31 OpenTank main board v0.1: KiCad schematic, PCB and Gerbers
    [drive.kicad_sch, expander.kicad_sch, extras.kicad_sch, io.kicad_sch, lights.kicad_sch, mcu.kicad_sch, power.kicad_sch, sound.kicad_sch]
2026-10-31 v0.1.1: add QR code to silkscreen, updated Gerbers
    [tank_board.kicad_pcb]
2026-11-02 Add gyro board v0.1 (BNO085): KiCad schematic, PCB and Gerbers
    [gyro_board.kicad_pcb, gyro_board.kicad_sch]
